lpnam1411/Scara_Robot/Scara_video_demo/3. Ảnh thực tế/received_490819612952527.jpeg

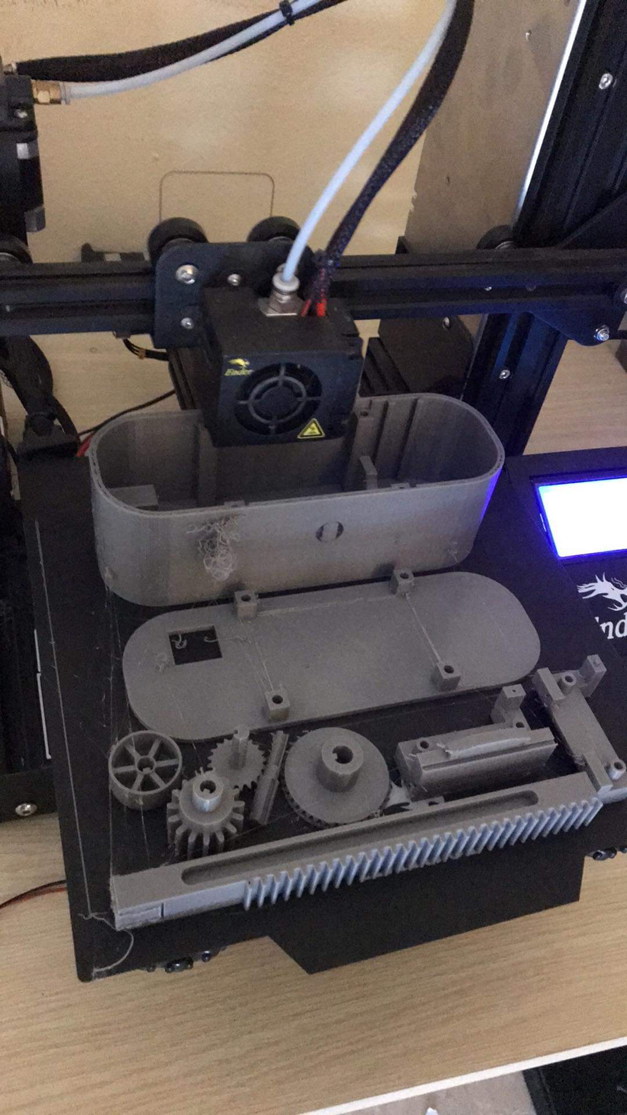
Scara_video_demo/3. Ảnh thực tế/received_490819612952527.jpeg
