lpnam1411/Scara_Robot/Scara_video_demo/2. Ảnh/IMG_20221110_121234.jpg

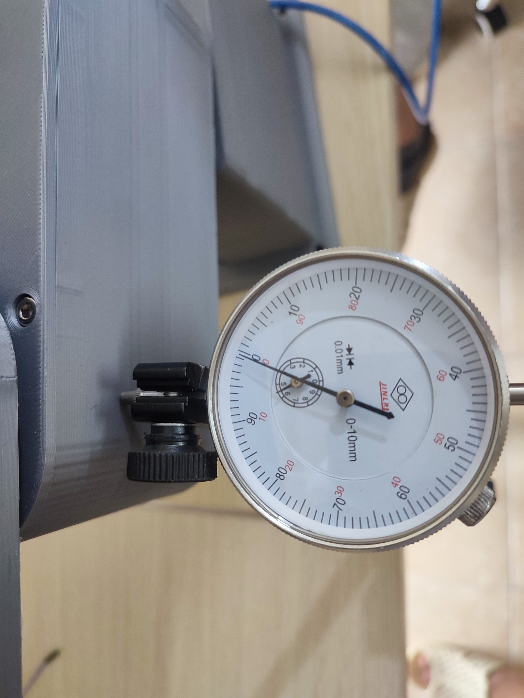
Scara_video_demo/2. Ảnh/IMG_20221110_121234.jpg
