lpnam1411/Scara_Robot/README.md

# Scara_Robot
 Bai tap lon Robot

Facebook: https://www.facebook.com/phannam.lee

Video demo: https://www.youtube.com/watch?v=TgQP_xQG-5g
