lpnam1411/Scara_Robot/Slide/Slide giữa kỳ - Robot Scara.pdf

# Thiết kế, chế tạo và khảo sát robot Scara

Thành viên:

Hoàng Văn Kiên

Đỗ Đức Mạnh

Lê Phấn Nam

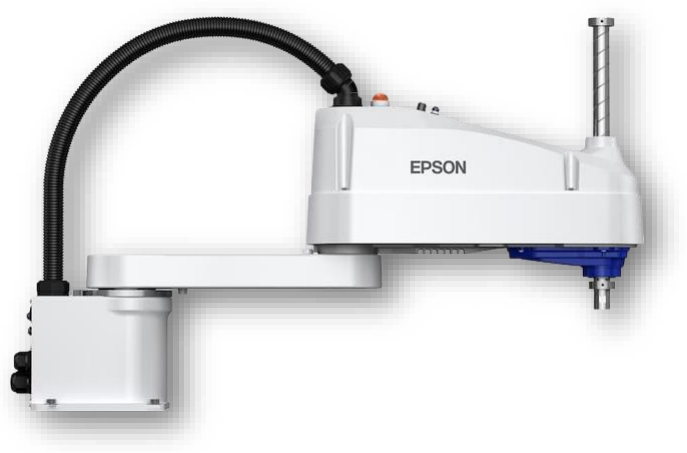
[picture p52: figure]

Giảng viên hướng dẫn:

TS. Dương Xuân Biên

## Nội dung

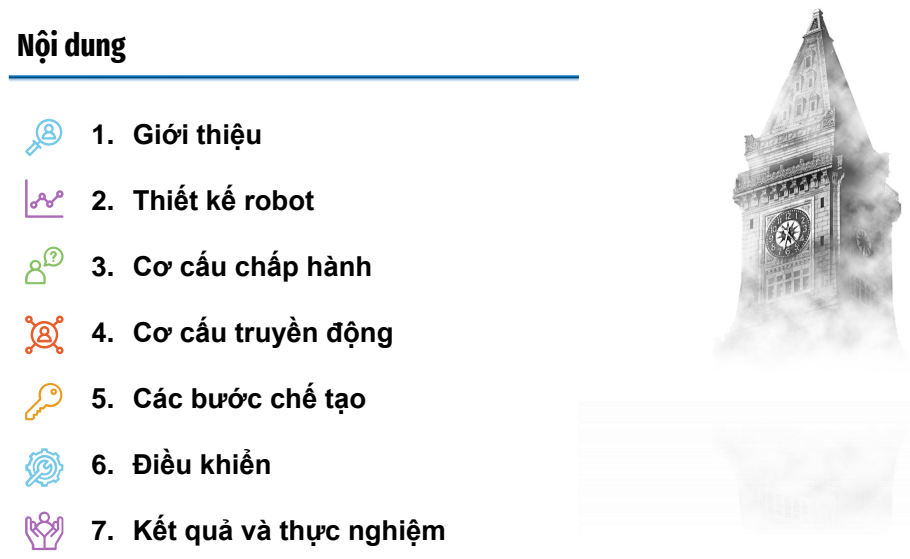
[picture p53: page 2]
1. Giới thiệu; 6. Điều khiển

2. Thiết kế robot

3. Cơ cấu chấp hành

4. Cơ cấu truyền động

5. Các bước chế tạo

7. Kết quả và thực nghiệm

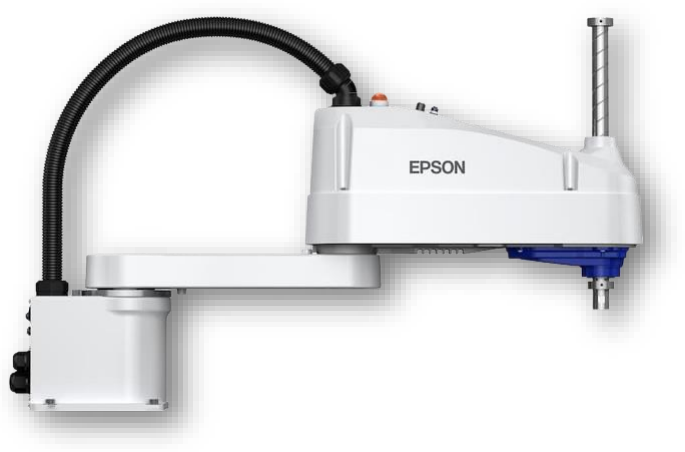
[picture p54: figure]

Robot Scara công nghiệp

## 1. Giới thiệu

- Robot Scara được đề xuất đầu tiên vào

năm 1979 tại Nhật Bản

- Ưu điểm:
- Tốc độ
- Chính xác tuyệt đối
- Độ lặp lại
- Khả năng linh động
a. Scara

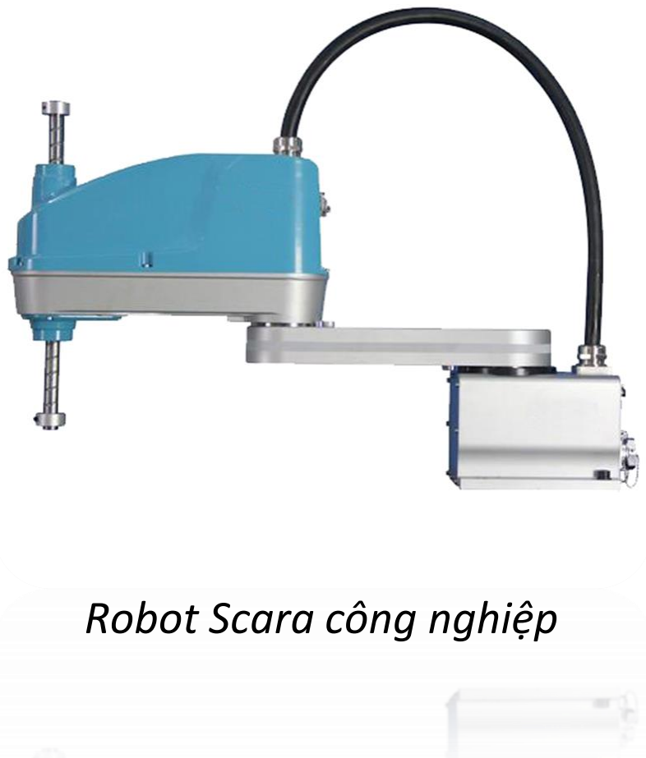
[picture p55: figure]
Robot Scara công nghiệp

Tay máy công nghiệp kích thước lớn,

độ chính xác tuyệt đối, giá thành cao.

Thiết kế robot Scara quy mô nhỏ, phù

hợp với sinh viên nghiên cứu và học tập.

## 1. Giới thiệu

b. Mục tiêu

## 1. Giới thiệu

c. Đề xuất thiết kế
Các tham số | Yêu cầu
Loại tay máy | Scara
Số bậc tự do | 3 bậc
Phạm vi hoạt động | Bán kính 20-30cm
Khối lượng | <=2kg
Vật liệu | Nhựa in PLA công nghệ in 3D
Chi phí | 3.000.000đ

## 2. Thiết kế robot

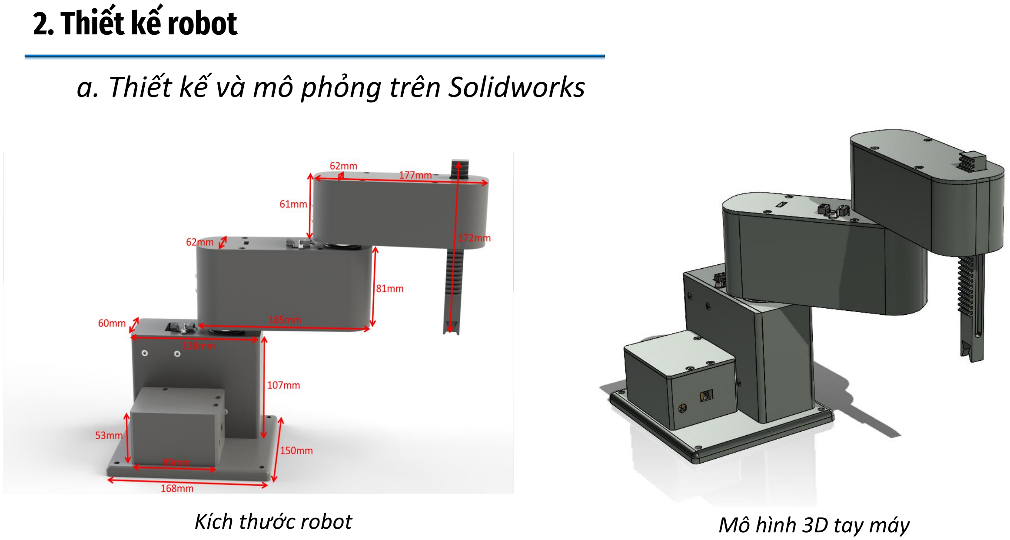
[picture p56: page 6]

a. Thiết kế và mô phỏng trên Solidworks
Kích thước robot | Mô hình 3D tay máy

## 2. Thiết kế robot

a. Thiết kế và mô phỏng trên Solidworks

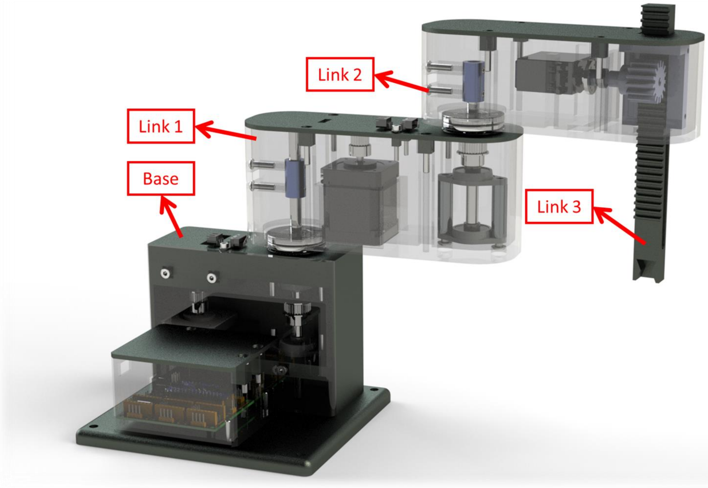
[picture p57: figure]

## 2. Thiết kế robot

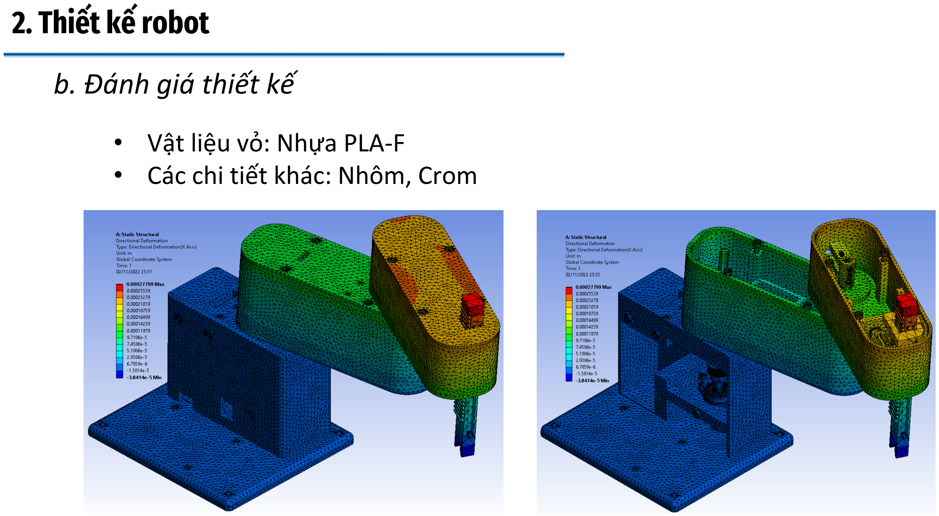
[picture p58: page 8]

b. Đánh giá thiết kế
- Vật liệu vỏ: Nhựa PLA-F
- Các chi tiết khác: Nhôm, Crom

## 3. Cơ cấu chấp hành

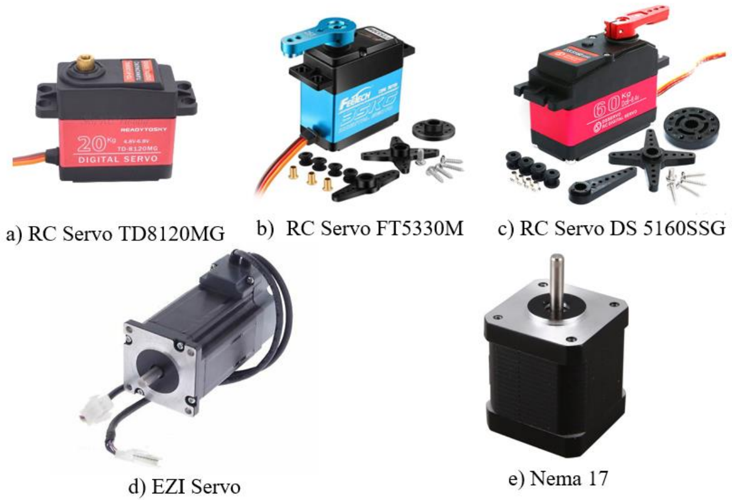
[picture p59: figure]

Các loại động cơ thường dùng trong tay máy robot

Tiêu chí

- Độ chính xác cao
- Điều khiển dễ dàng
- Tuổi thọ tốt
- Giá thành hợp lý
a. Lựa chọn động cơ

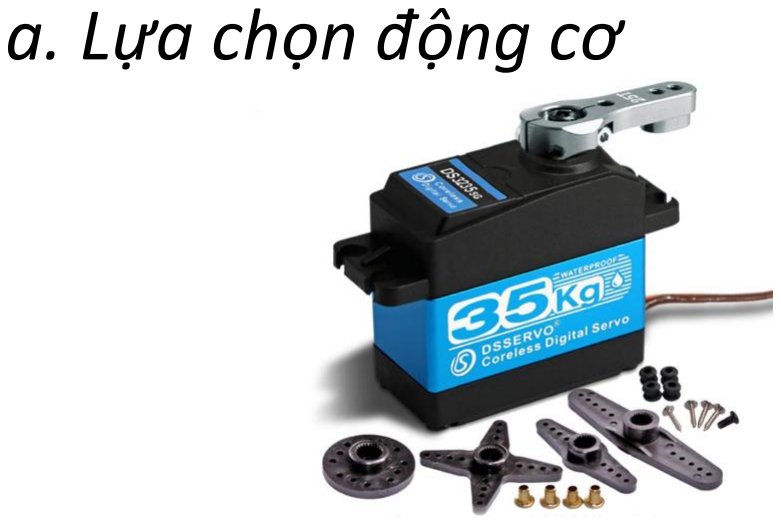
[picture p60: figure]
a. Lựa chọn động cơ
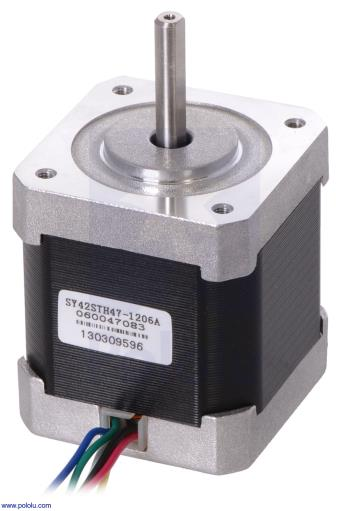
[picture p61: figure]

Servo motor | Step motor

## 3. Cơ cấu chấp hành

Đặc điểm | Servo | Step
Bước | 1 o | 1.8o – 1.8/16o
Vận tốc | Không | Có
Gia tốc | Không | Có
Driver | Tích hợp sẵn | Có
Encoder | Có | Không

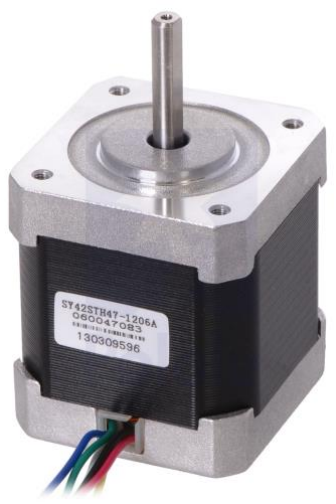
[picture p62: figure]

Nema 17HS8401s
Thông số | Nema 17HS8401s
Nguồn (V) | 12 - 24
Dòng (A) | 1.8
Momen xoắn (Ncm) | 2.6
Kích thước (mm) | 42 × 42 × 48
Khối lượng (g) | 368

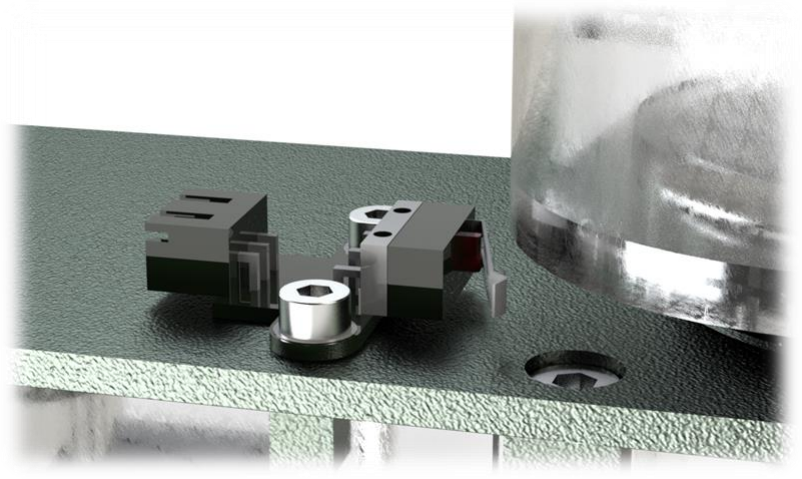
[picture p63: figure]
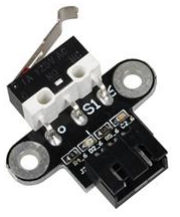
[picture p64: figure]

Công tắc hành trình

Trạng thái nút bấm | Giá trị trả về
Kích hoạt | 1
Chưa kích hoạt | 0

## 3. Cơ cấu chấp hành

b. Thông số động cơ

## 4. Cơ cấu truyền động

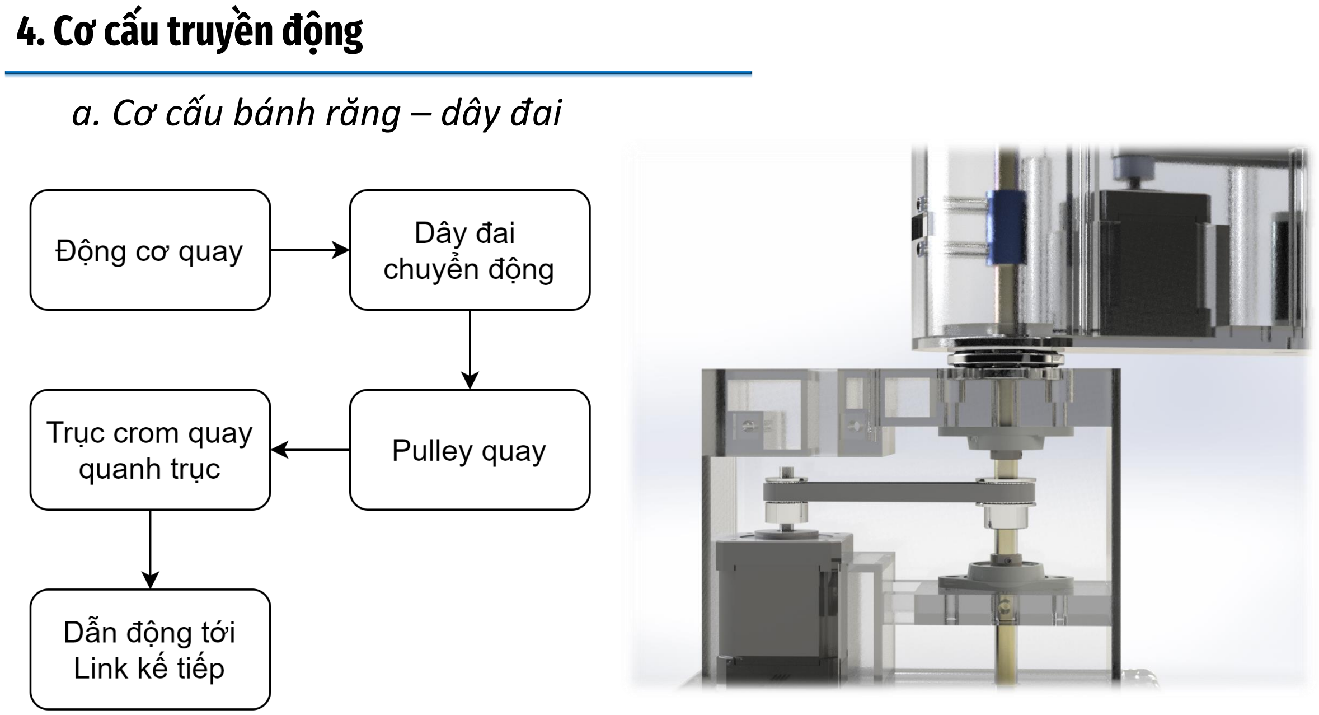
[picture p65: page 12]

a. Cơ cấu bánh răng – dây đai

## 4. Cơ cấu truyền động

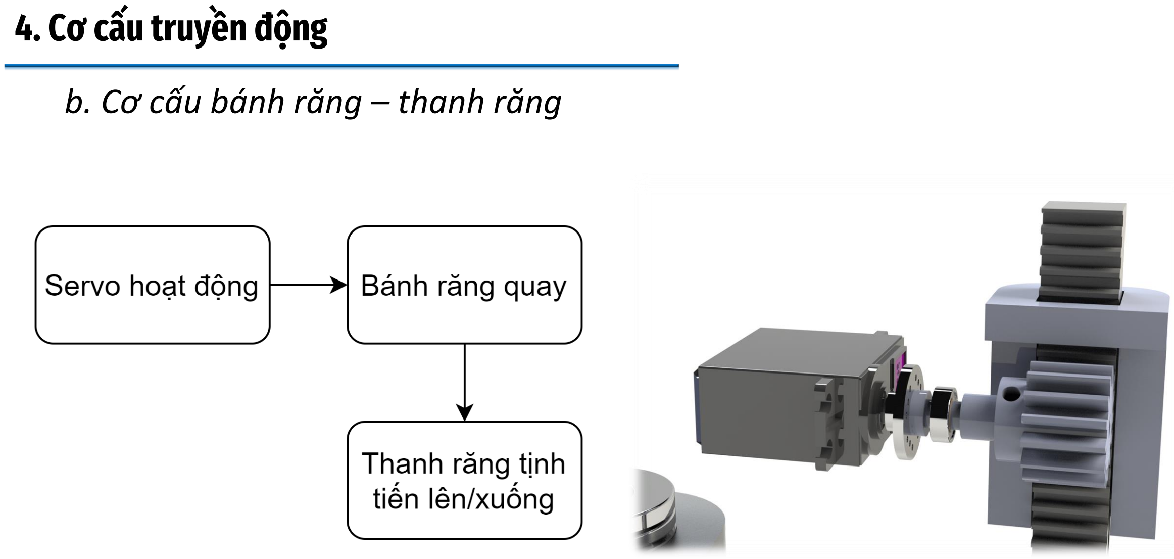
[picture p66: page 13]

b. Cơ cấu bánh răng – thanh răng

## 5. Các bước chế tạo

a. Video toàn cảnh

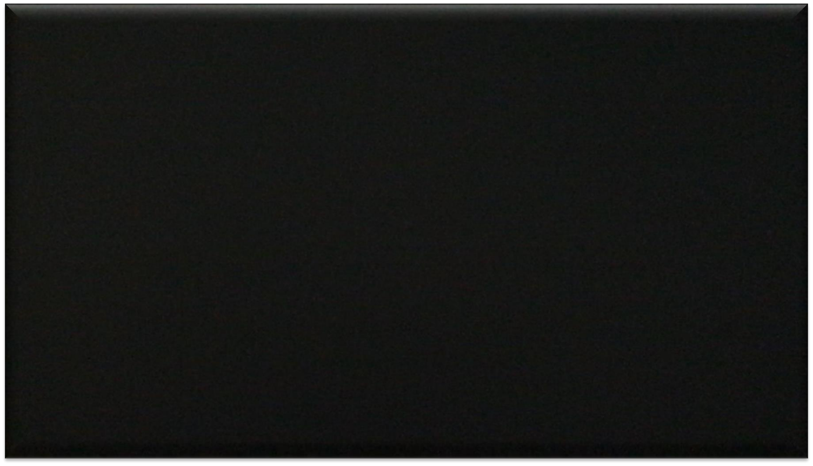
[picture p67: figure]

## 5. Các bước chế tạo

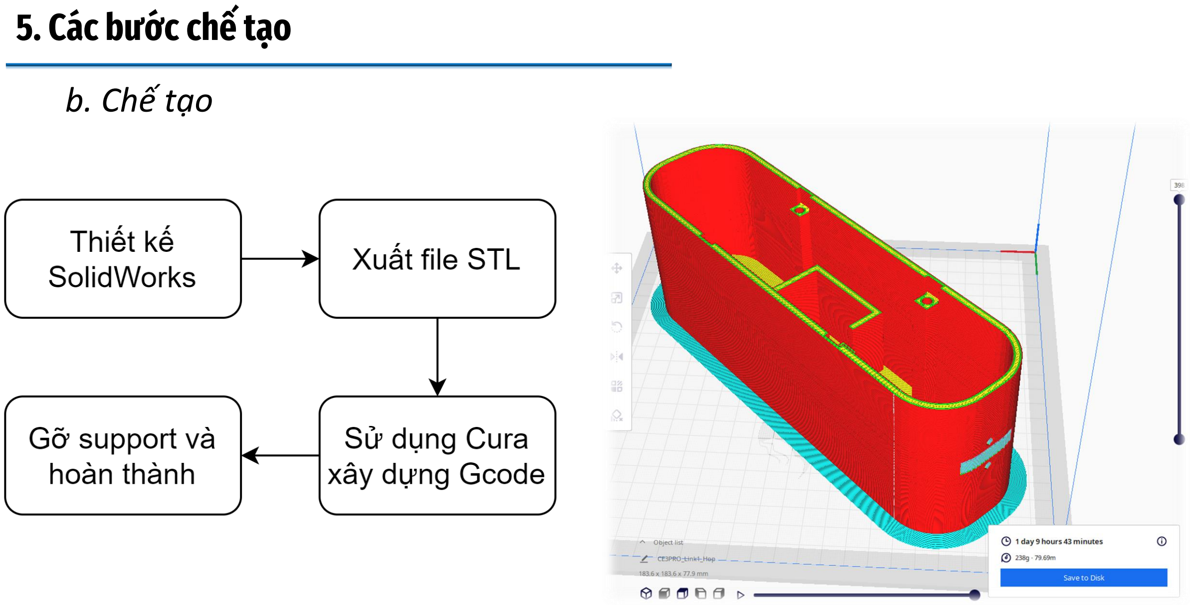
[picture p68: page 15]

b. Chế tạo

## 5. Các bước chế tạo

b. Chế tạo

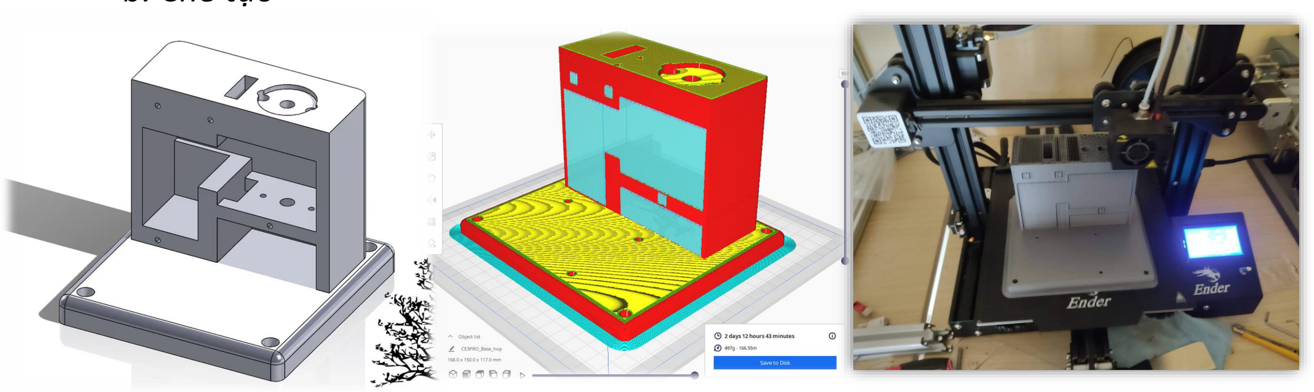
[picture p69: figure]

Mô phỏng SolidWorks | Xuất Gcode trên Cura | Bắt đầu in trên máy

## 5. Các bước chế tạo

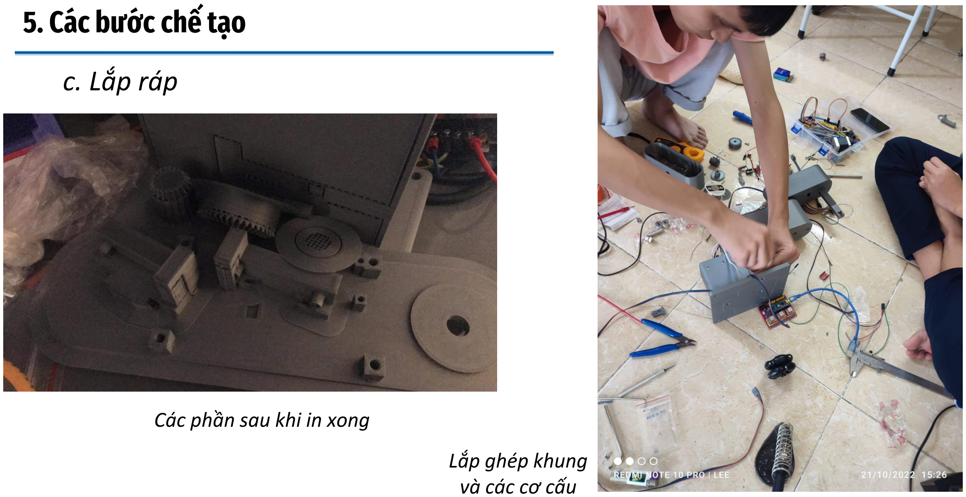
[picture p70: page 17]

c. Lắp ráp

Các phần sau khi in xong

Lắp ghép khung
và các cơ cấu

## 5. Các bước chế tạo

d. Sản phẩm

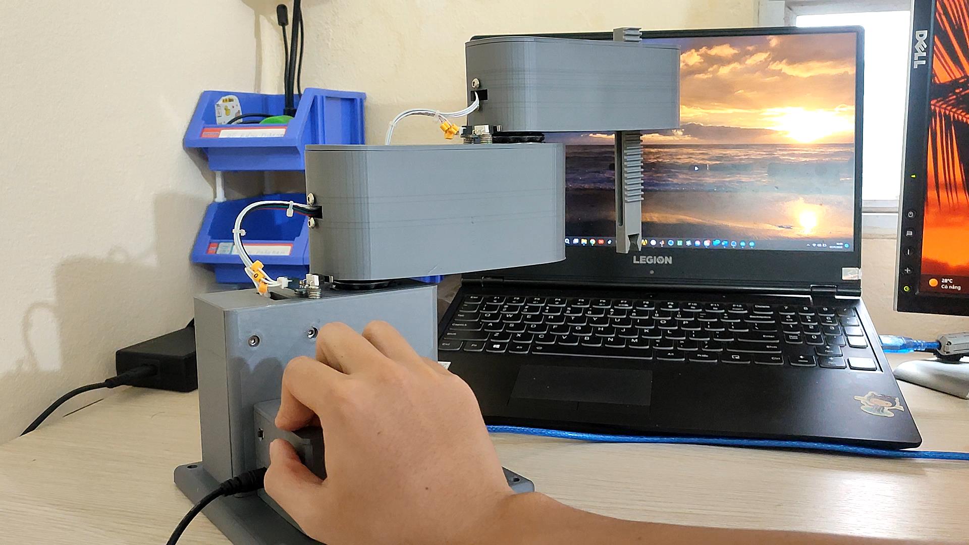
[picture p71: figure]

## 6. Điều khiển

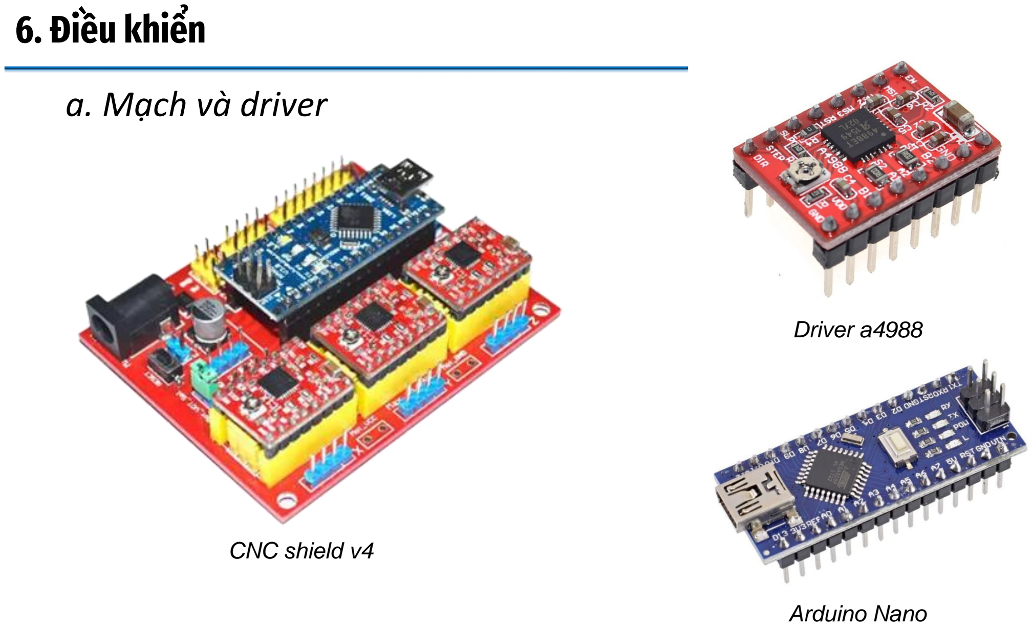
[picture p72: page 19]

a. Mạch và driver

CNC shield v4

Driver a4988

Arduino Nano

## 6. Điều khiển

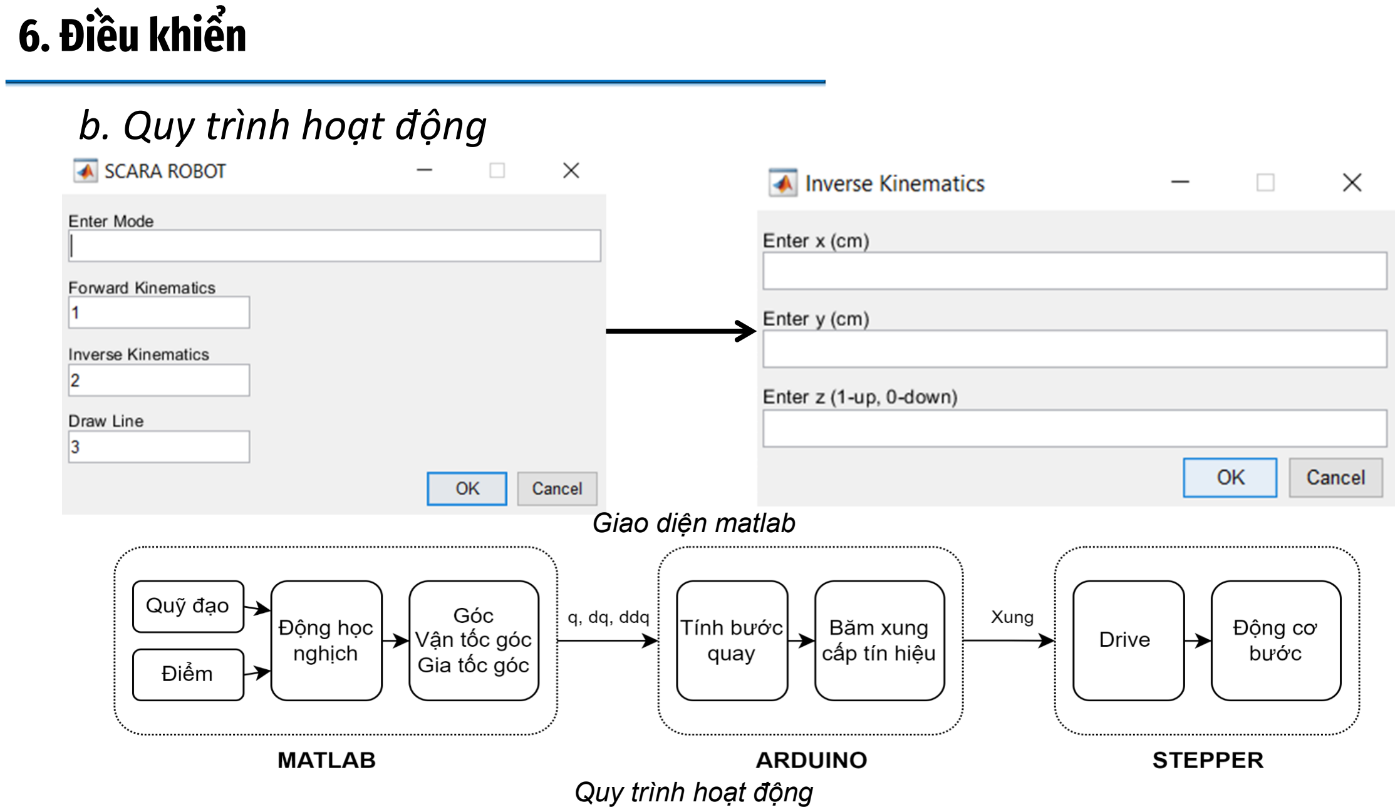
[picture p73: page 20]

b. Quy trình hoạt động

Quy trình hoạt động

Giao diện matlab

## 6. Điều khiển

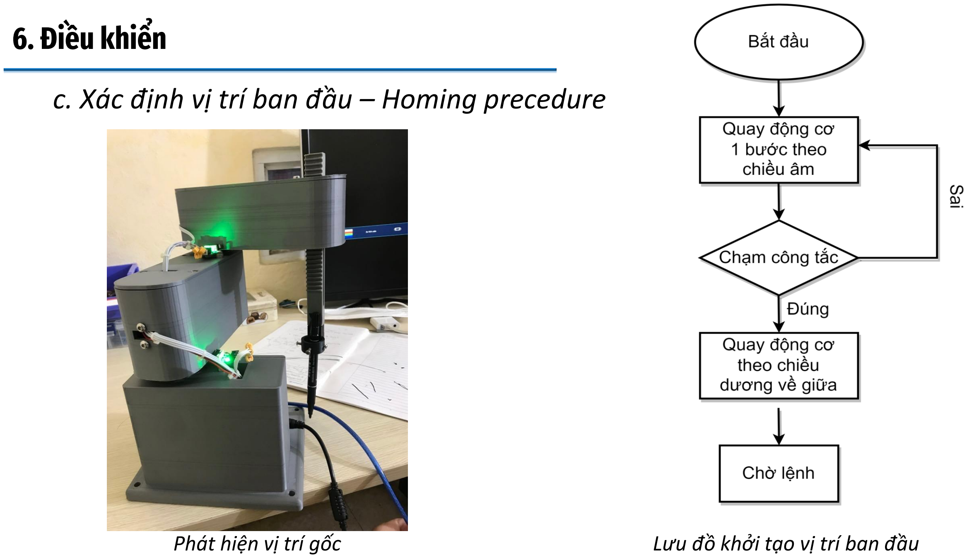
[picture p74: page 21]

c. Xác định vị trí ban đầu – Homing precedure
Phát hiện vị trí gốc | Lưu đồ khởi tạo vị trí ban đầu

## 6. Điều khiển

d. Phương pháp điều khiển
| Phương pháp hình học | Phương pháp toán học
Động học thuận | x L L 1 1 1 1 + + L 2 L 2 2 2 sin θ cos θ θ θ ( θ θ ( 1 1 + sin + cos 2 = 2 = ) y )
Động học nghịch | L x + L x cos θ − L y sin θ θ = arctan 1 2 2 2 2 2 2 2 1 L y + L y cos θ + L x sin θ 1 2 2 2 2 2 2 2 2 2 ( 2 2 ) x + y − L + L 2 2 1 2 θ = arccos 2 2 LL 12 | ~ J E k 1 θ k ( ) k θ k θ t ⁺ + = + Δ

Trong đó:
( ) ( ) ( ) ( )

1
θ | θ | θ | θ

−
+
= | é | ù ë | û T | T J | J | J | J k | θ | θ θ

θ

∂
∂
f E = | =J( ) ( )
n θ | θ Î | Î m E =f | ,E R , | R

## 7. Kết quả và thực nghiệm

a. Video demo, chuyển động theo chữ A

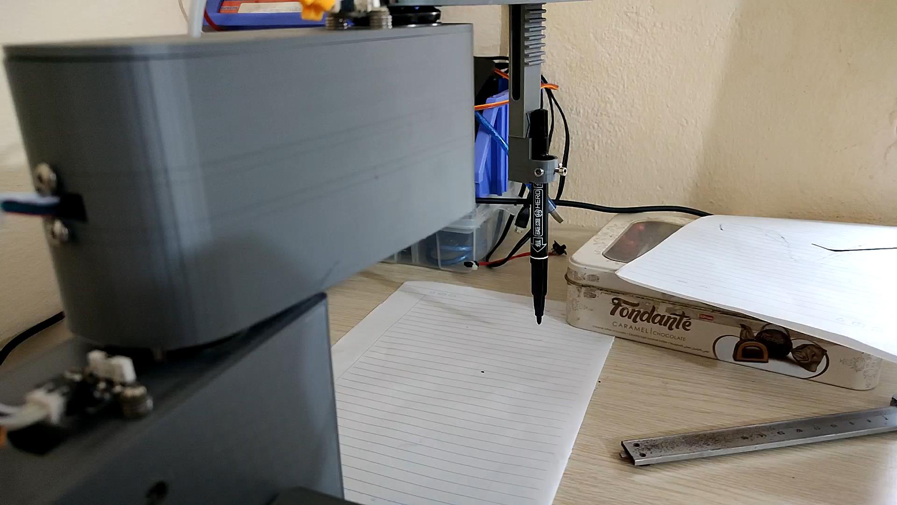
[picture p75: figure]

## 7. Kết quả và thực nghiệm

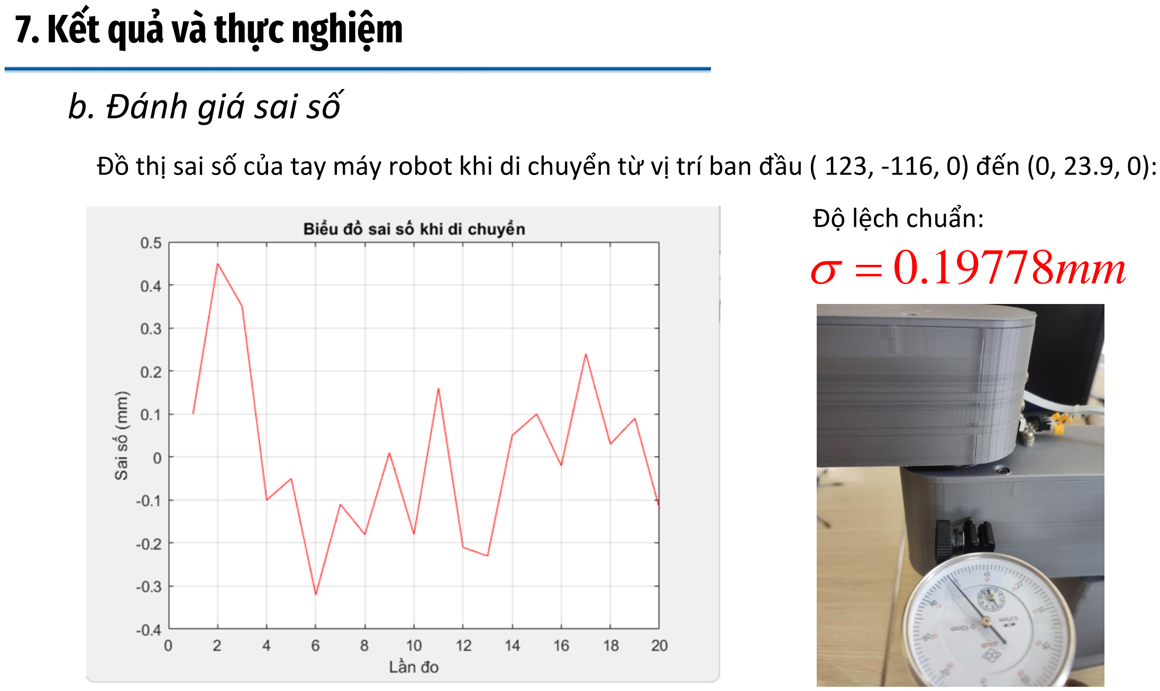
[picture p76: page 24]

b. Đánh giá sai số

Đồ thị sai số của tay máy robot khi di chuyển từ vị trí ban đầu ( 123, -116, 0) đến (0, 23.9, 0):

Độ lệch chuẩn:

## σ = 0.19778mm

## 7. Kết quả và thực nghiệm

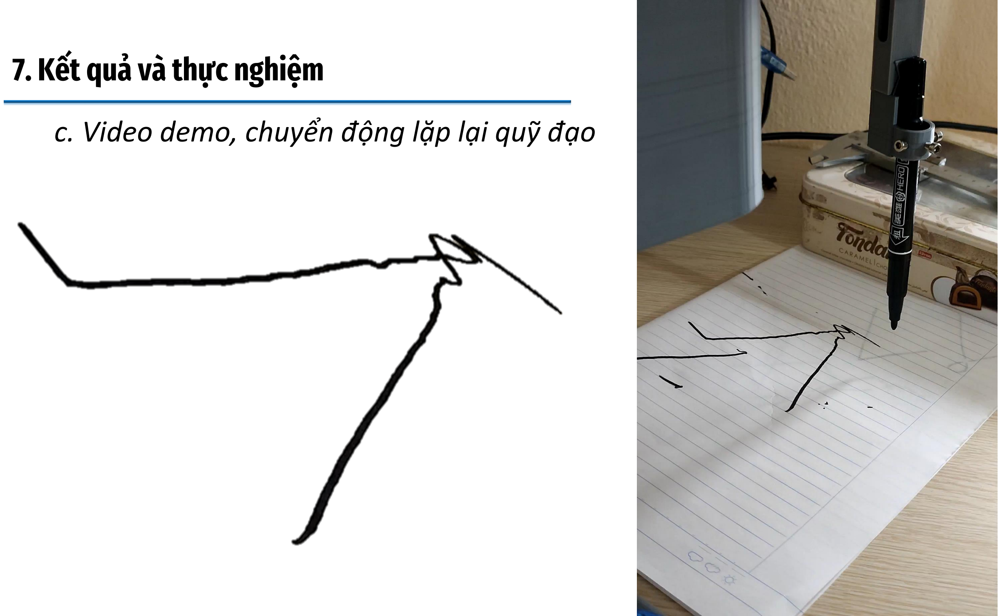
[picture p77: page 25]

c. Video demo, chuyển động lặp lại quỹ đạo

## 7. Kết quả và thực nghiệm

d. Video demo, chuyển động vẽ dấu tick “✓”

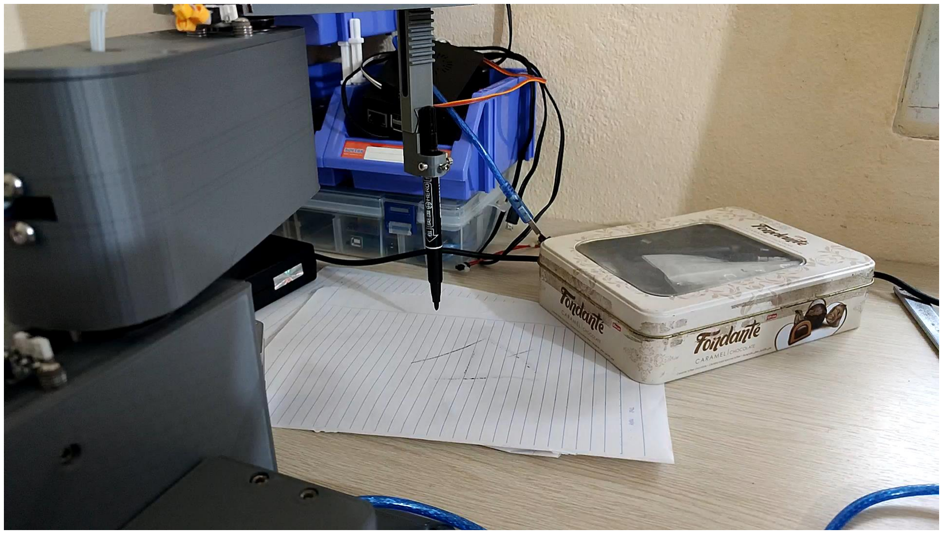
[picture p78: figure]

## 7. Kết quả và thực nghiệm

d. Video demo, chuyển động vẽ dấu tick “✓”

## 7. Kết quả và thực nghiệm

e. Bảng đánh giá thực tế
Tiêu chí | Thực tế
Phạm vi hoạt động | 24.1 cm
Khối lượng | 1.4 kg
Độ chính xác | ± 0.1977 mm
Tốc độ | 1.5 rpm
Giá thành | 4,000,000 vnđ

## Khó khăn và khắc phục

a. Khó khăn
- Khung máy in 3D gây ra sai số so với mô hình mô phỏng ví dụ

như mặt đế hơi cong, các góc bo không được tròn.
- Mạch điều khiển giá thành rẻ, xuất hiện nhiễu nhiều.
- Động cơ chưa đáp ứng được tải khi robot hoạt động .
- Giao tiếp matlab to Arduino chưa ổn định.
- Giao diện điều khiển chưa hoàn chỉnh.
- Phương pháp điều khiển hình học còn tồn tại điểm kì dị gây ra

tính toán góc sai.

## Khó khăn và khắc phục

b. Định hướng tương lai
- Tích hợp thêm cảm biến khoảng cách, giúp phần cân bàn cho

điểm E được tự động hoá và chính xác hơn.

- Sử dụng thêm camera, xử lý ảnh phát hiện vật và gắp vật.
- Tích hợp xử lý ảnh, nhận diện ảnh có sẵn và vẽ theo mẫu.
- Cải thiện về tốc độ cho robot, nâng cao tính ổn định khi

chuyển động với vận tốc cao đồng thời giảm sai số, khi hoạt

động của robot.

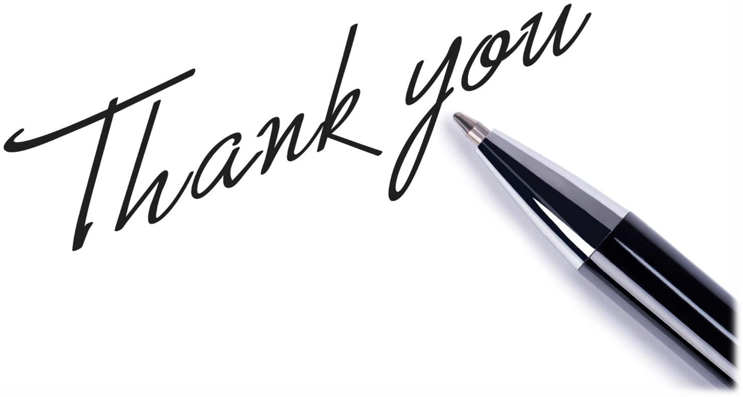
[picture p79: page 31]
