lpnam1411/Scara_Robot/Scara_Code/1. Động học/1. maple/Scara_Kinematic.docx

SCARA

A. Mô hình Robot SCARA
I. Phân tích mô hình Robot

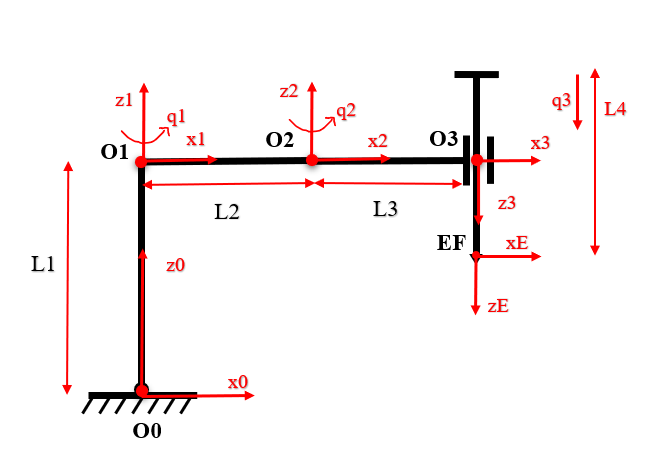
[picture p80: figure]

Hình 1: Mô hình Robot SCARA

II. Mô hình hóa toán học
1. Đặt hệ trục tọa độ cố định và địa phương
2. Lập bảng DH:

Bảng 1.

Dịch chuyển | Khâu | Q | D | A | Anpha
0-1 | | 0 | L1 | 0 | 0
1-2 | | Q1 | 0 | L2 | 0
2-3 | | Q2 | 0 | L3 | Pi
3-E | | 0 | Q3 | 0 | 0
