lpnam1411/Scara_Robot/Scara_Code/1. Động học/3. Phương trình hình học/Giải hình học.docx

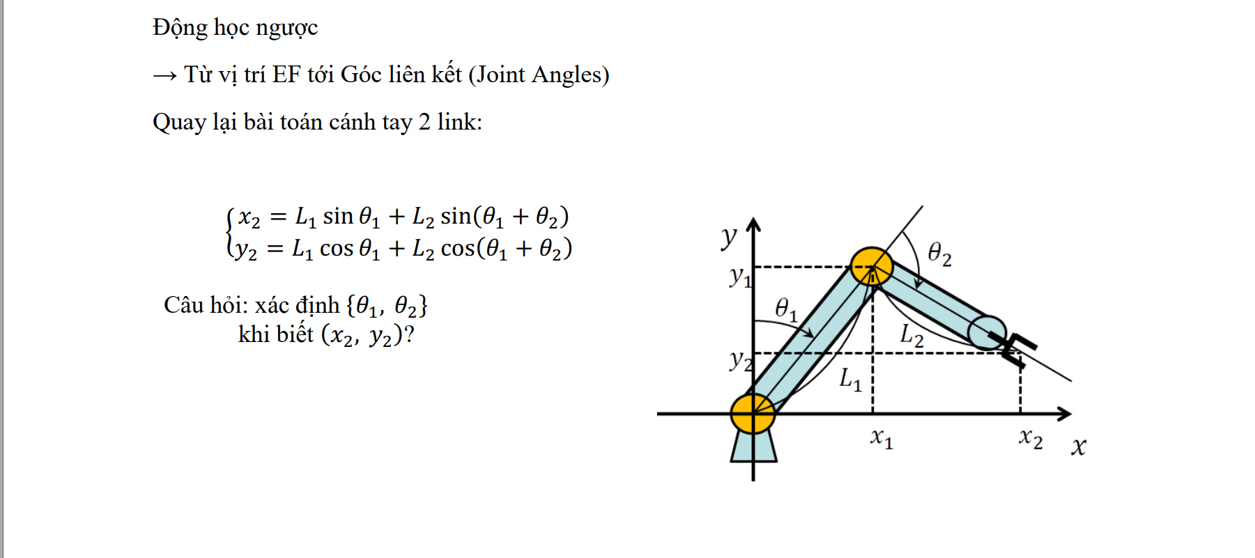
[picture p81: figure]
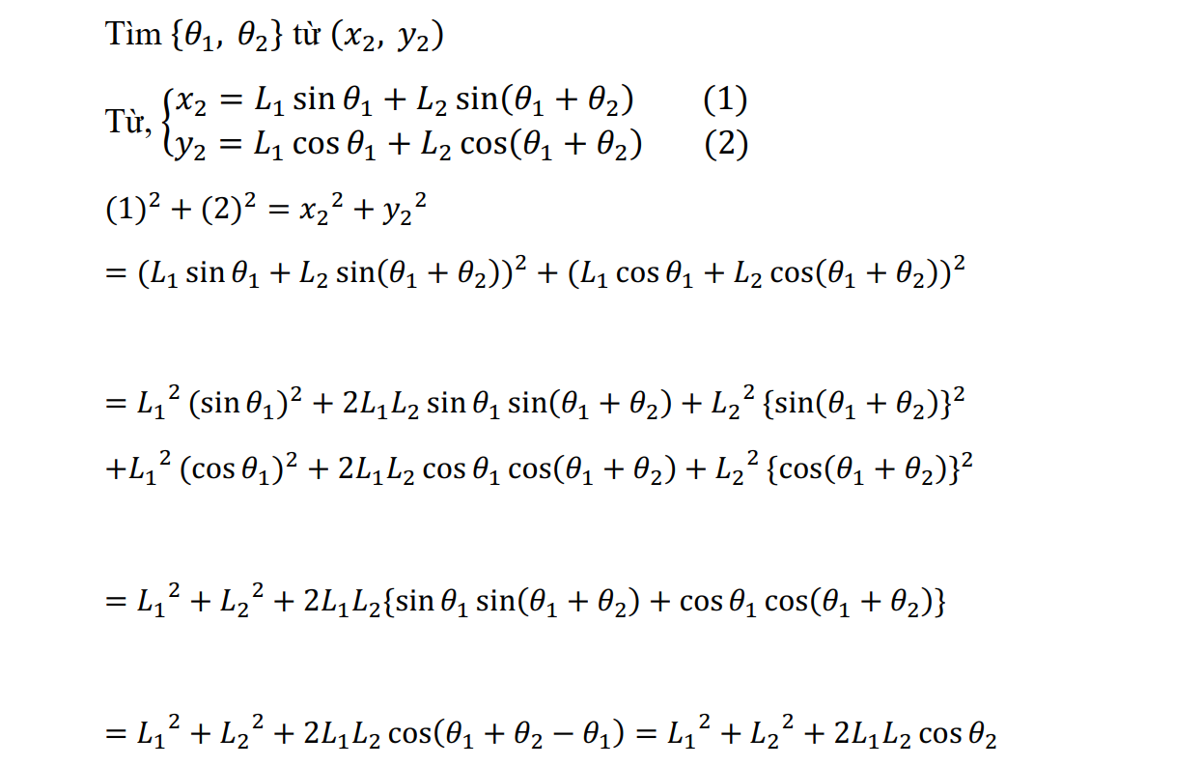
[picture p82: figure]
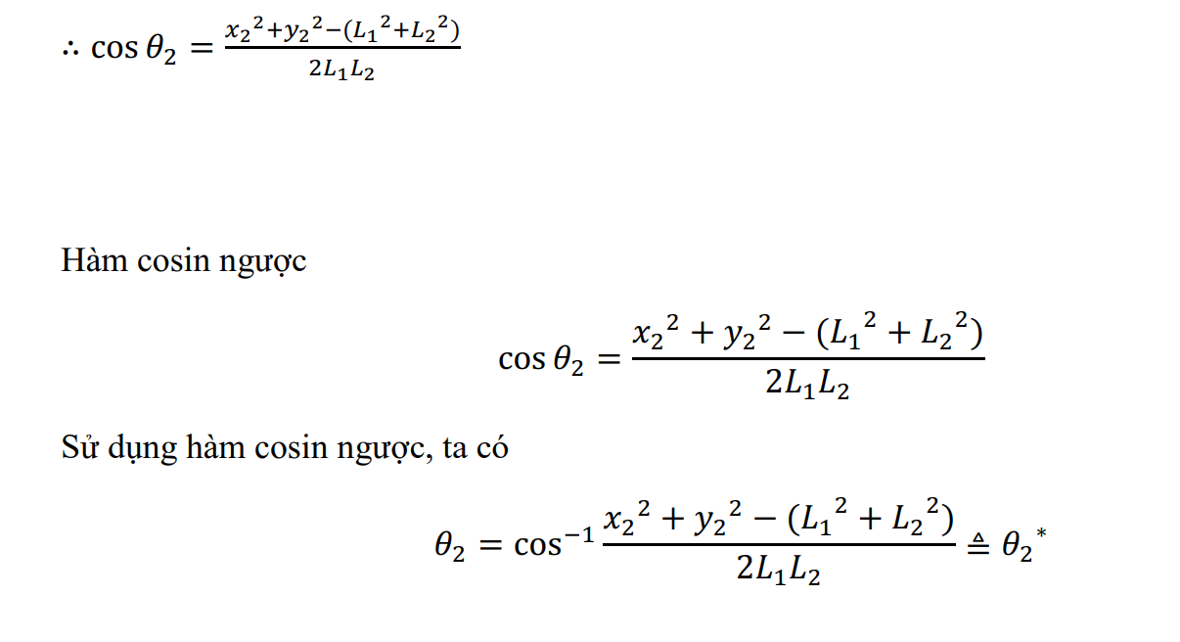
[picture p83: figure]
