lpnam1411/Scara_Robot/Scara_video_demo/3. Ảnh thực tế/base_slw.webp

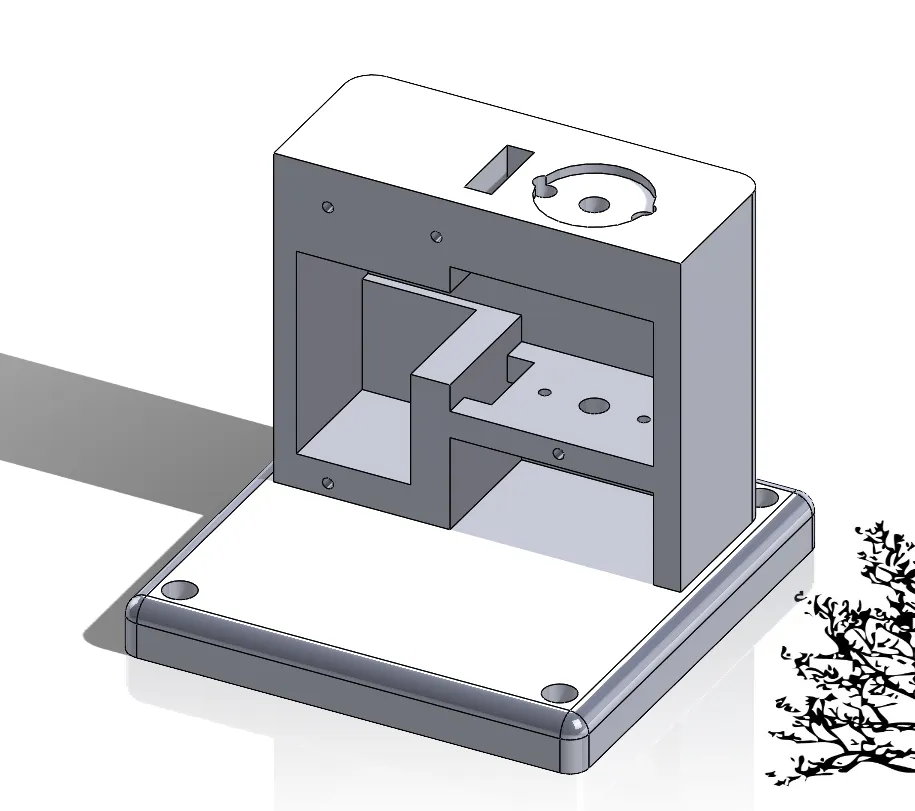
Scara_video_demo/3. Ảnh thực tế/base_slw.webp
