lpnam1411/Scara_Robot/Scara_video_demo/3. Ảnh thực tế/linh kiện.jpeg

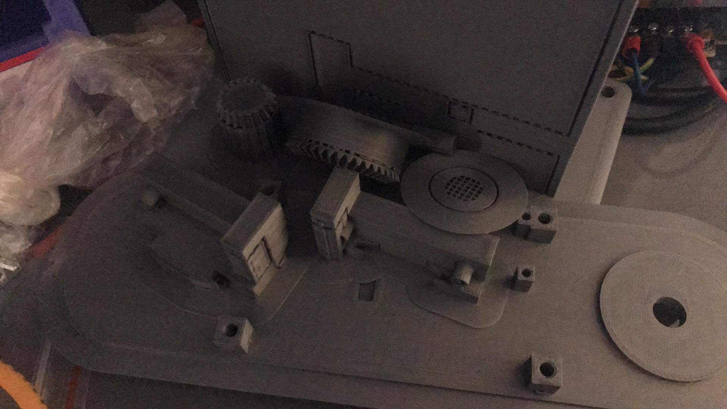
Scara_video_demo/3. Ảnh thực tế/linh kiện.jpeg
