lpnam1411/Scara_Robot/Scara_video_demo/3. Ảnh thực tế/lắp.jpeg

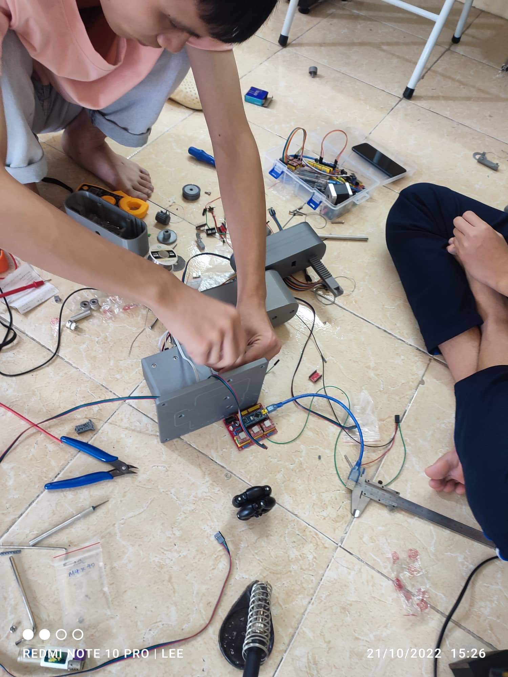
Scara_video_demo/3. Ảnh thực tế/lắp.jpeg
