lpnam1411/Scara_Robot/Scara_video_demo/3. Ảnh thực tế/received_675763930218119.webp

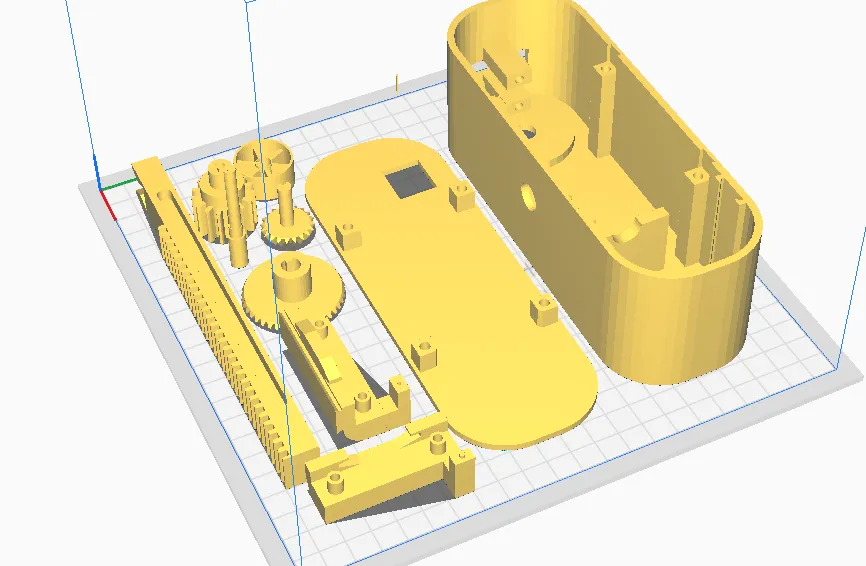
Scara_video_demo/3. Ảnh thực tế/received_675763930218119.webp
