lpnam1411/Scara_Robot/Scara_video_demo/3. Ảnh thực tế/received_858242992252694.jpeg

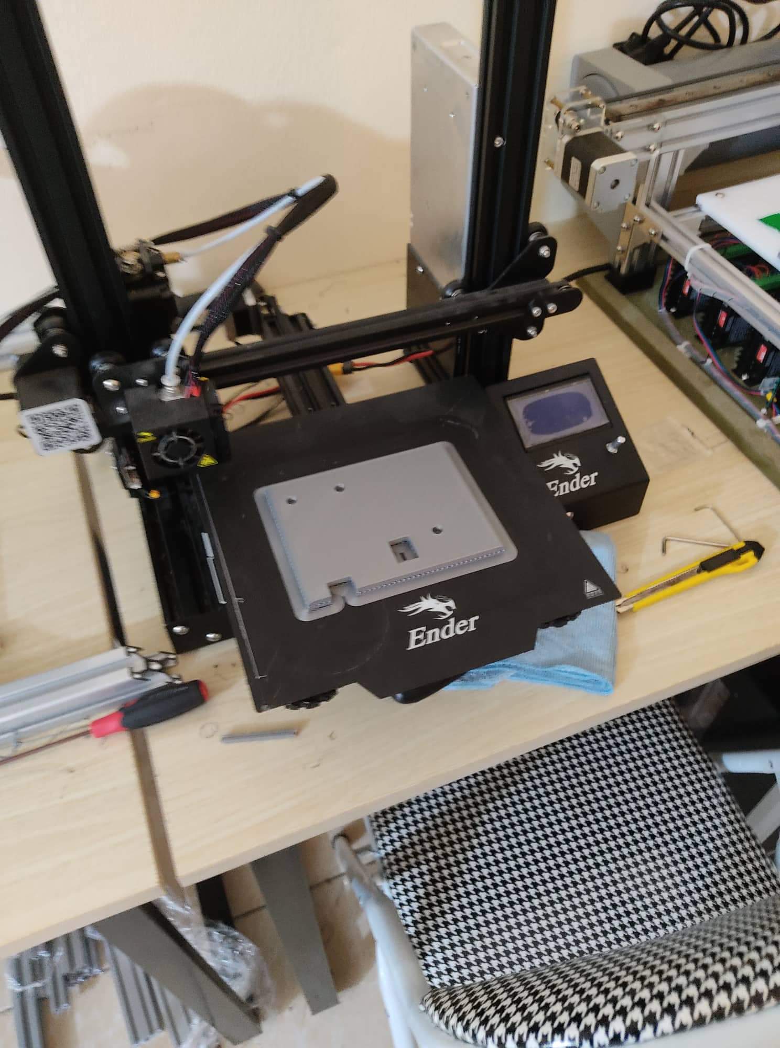
Scara_video_demo/3. Ảnh thực tế/received_858242992252694.jpeg
