lpnam1411/Scara_Robot/Scara_video_demo/3. Ảnh thực tế/received_1276213099846674.jpeg

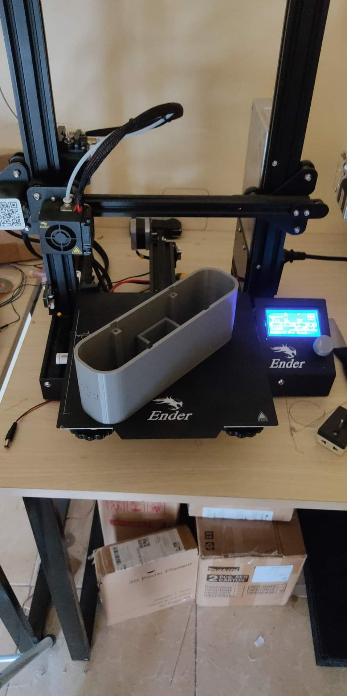
Scara_video_demo/3. Ảnh thực tế/received_1276213099846674.jpeg
