lpnam1411/Scara_Robot/Scara_3D_design/Linh kiện/servo-mg-996r.SLDASM

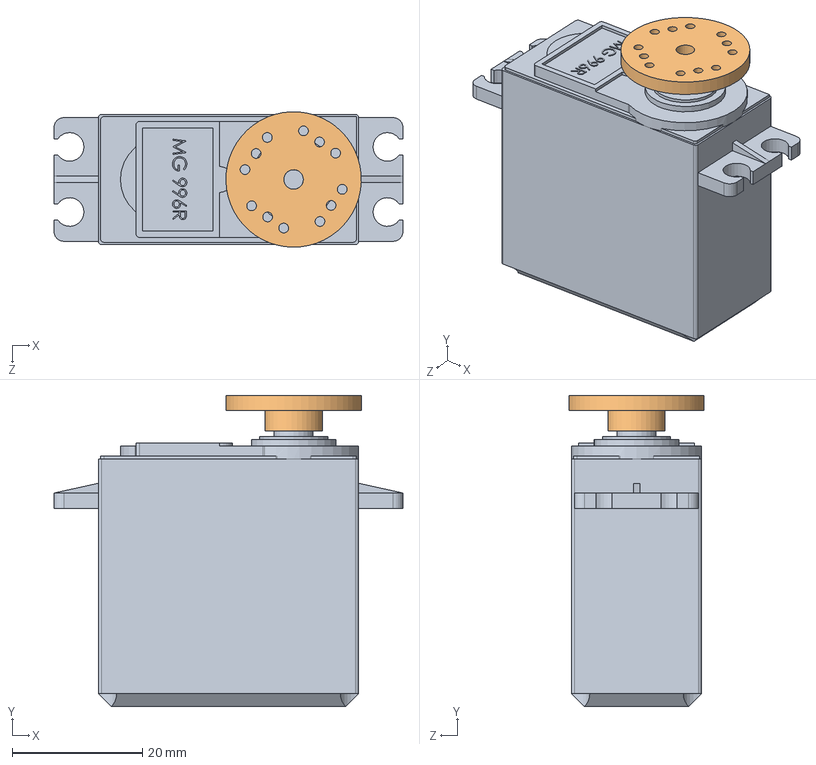
[picture p91: CAD file, 2023-01-28]
Scara_3D_design/Linh kiện/servo-mg-996r.SLDASM
53.6 x 47.8 x 20.8 mm
##Servo_MG_996R
Circle Rudder
