lpnam1411/Scara_Robot/Scara_3D_design/Trục/KFL08.SLDASM

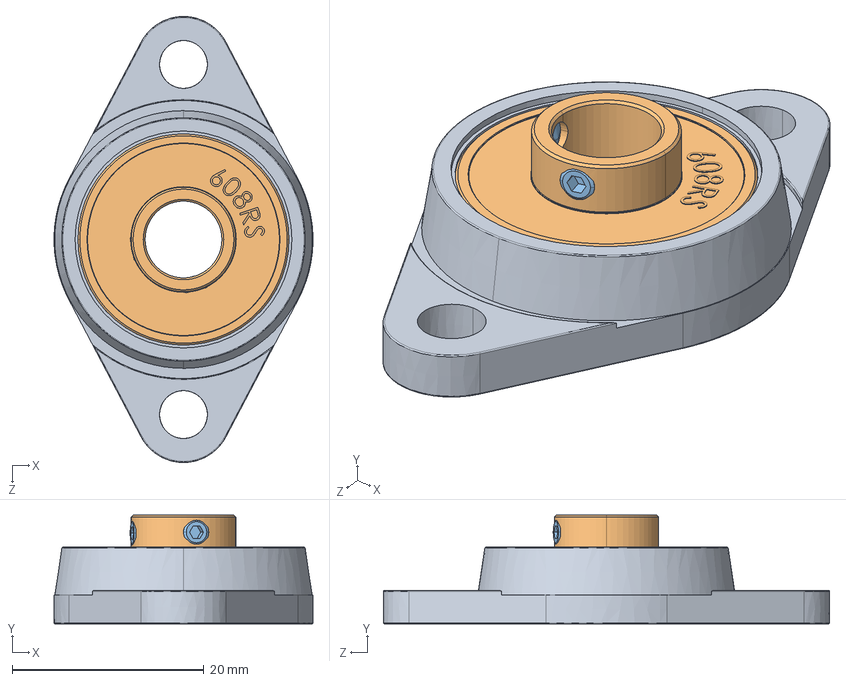
[picture p92: CAD file, 2023-01-28]
Scara_3D_design/Trục/KFL08.SLDASM
27.0 x 11.4 x 46.5 mm
KFL08.IGS
608RS.IGS
MOSCAM2,5.IGS x 2
