lpnam1411/Scara_Robot/Scara_3D_design/Rack and Pinion Gear/đỡ.SLDASM

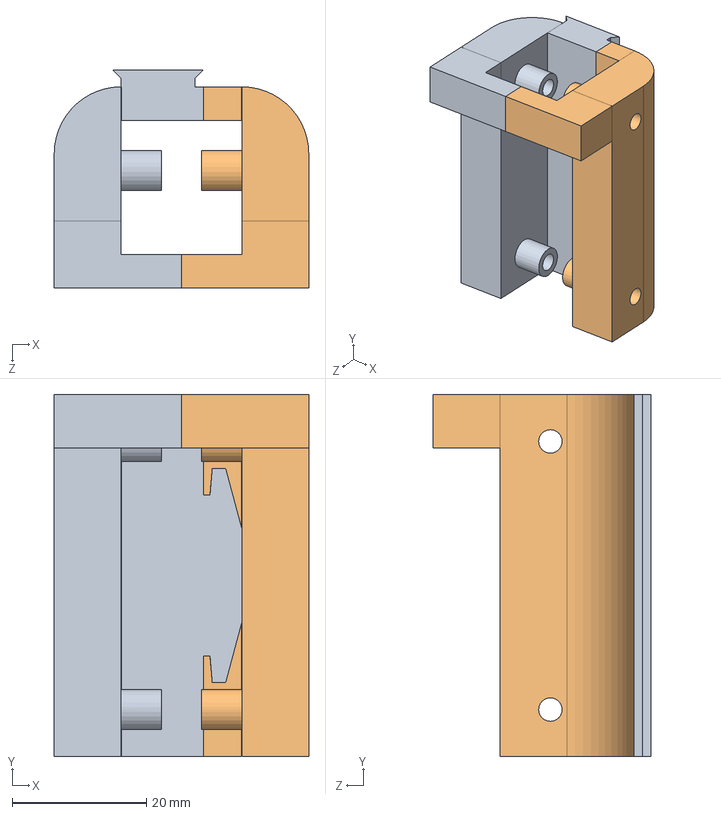
[picture p93: CAD file, 2023-01-28]
Scara_3D_design/Rack and Pinion Gear/đỡ.SLDASM
38.0 x 54.0 x 32.5 mm
Penyanga Rack - Copy
Penyanga Rack
