lpnam1411/Scara_Robot/Scara_3D_design/Linh kiện/Arduino Nano/Arduino nano.SLDASM

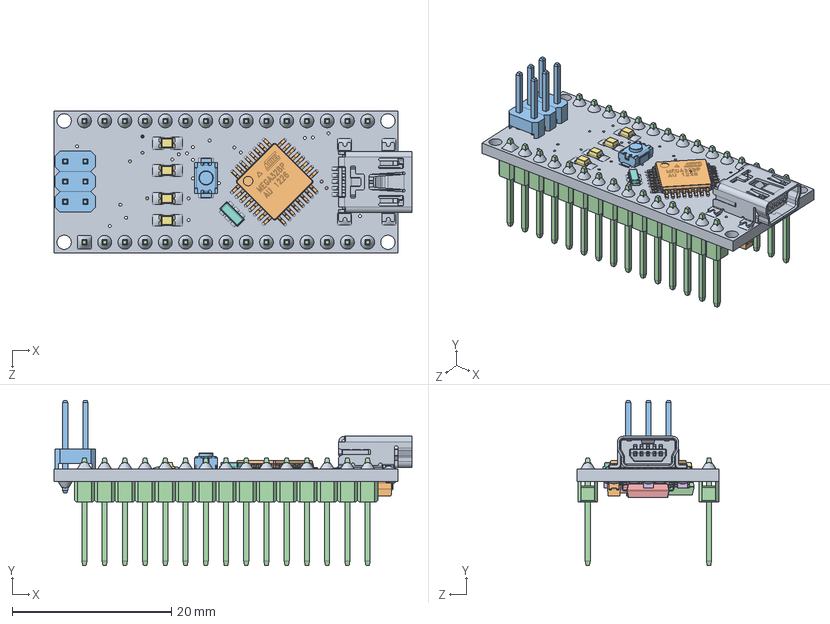
[picture p94: CAD file, 2023-01-28]
Scara_3D_design/Linh kiện/Arduino Nano/Arduino nano.SLDASM
45.0 x 20.7 x 17.8 mm
nano board
atmega328
PLD-2.step x 3
1x15 Male Pin Header x 2
FTDI FT232RL
User Library-C0805-2.step x 5
0805 Chip SMD LED (2x1.2mm).step x 4
SMD Crystal 16MHz
Mini B USB
Tantalum Capacitor 475C A3216 x 2
Pushbutton3x4x2
C5 FD10 Reg
Diode MBR0520
102 RESISTOR PACK
189 RESISTOR PACK
