lpnam1411/Scara_Robot/Scara_3D_design/Gripper/Gripper base bút.SLDPRT

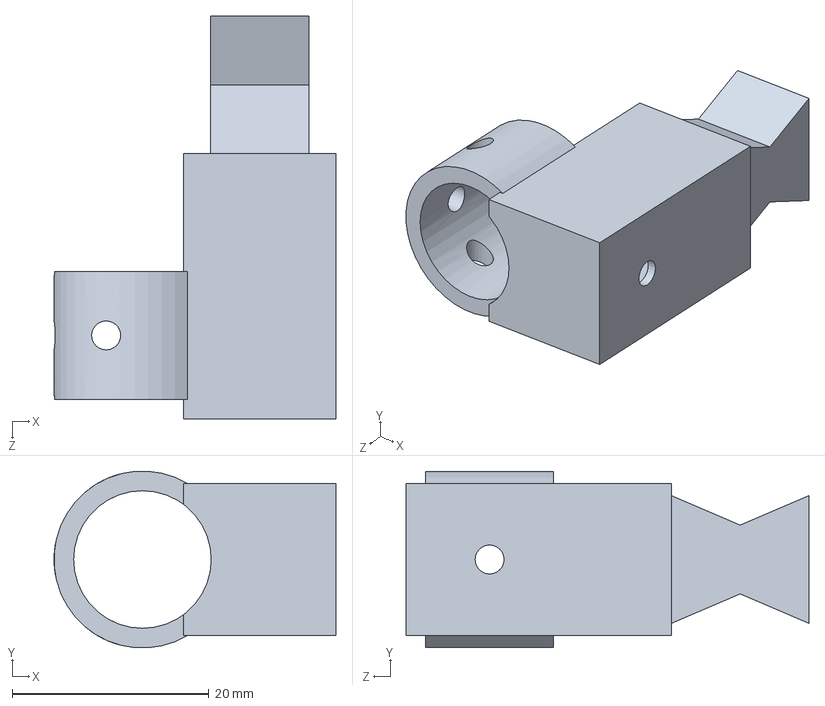
[picture p95: CAD file, 2023-01-28]
Scara_3D_design/Gripper/Gripper base bút.SLDPRT
28.7 x 18.0 x 41.0 mm
