lpnam1411/Scara_Robot/Scara_3D_design/Linh kiện/Arduino Nano/Mini B USB.SLDPRT

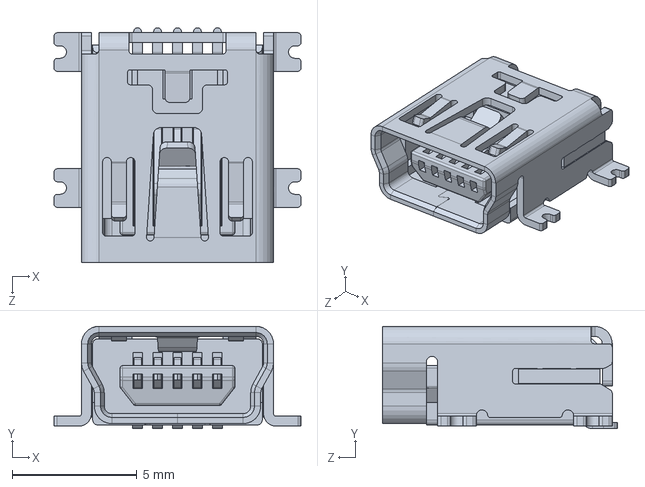
[picture p96: CAD file, 2023-01-28]
Scara_3D_design/Linh kiện/Arduino Nano/Mini B USB.SLDPRT
9.90 x 4.10 x 9.40 mm
