lpnam1411/Scara_Robot/Scara_3D_design/Linh kiện/servo-mg-996r-2.snapshot.1/Servo/##Servo_MG_996R.SLDPRT

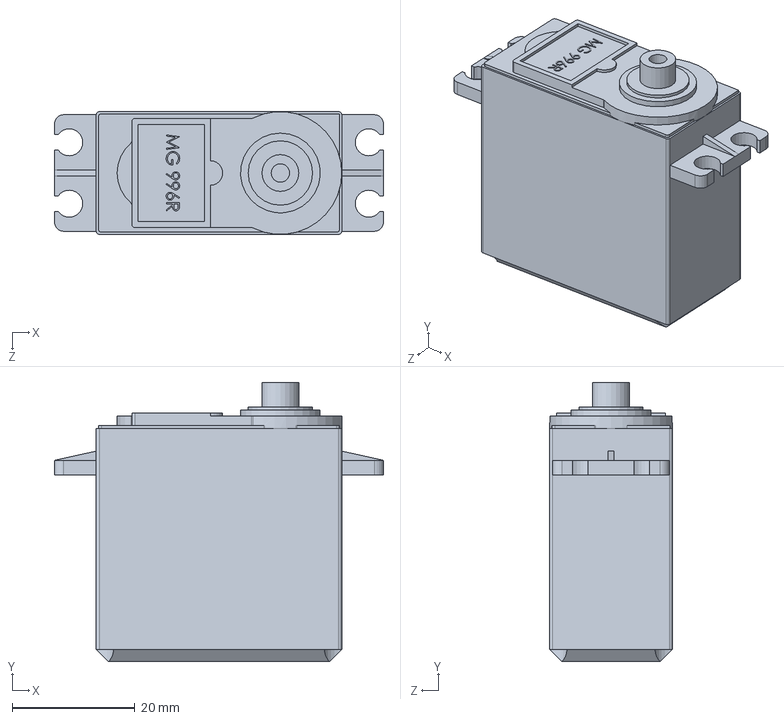
[picture p97: CAD file, 2023-01-28]
Scara_3D_design/Linh kiện/servo-mg-996r-2.snapshot.1/Servo/##Servo_MG_996R.SLDPRT
53.6 x 45.5 x 20.0 mm
