lpnam1411/Scara_Robot/Scara_3D_design/Link1_Hop.SLDPRT

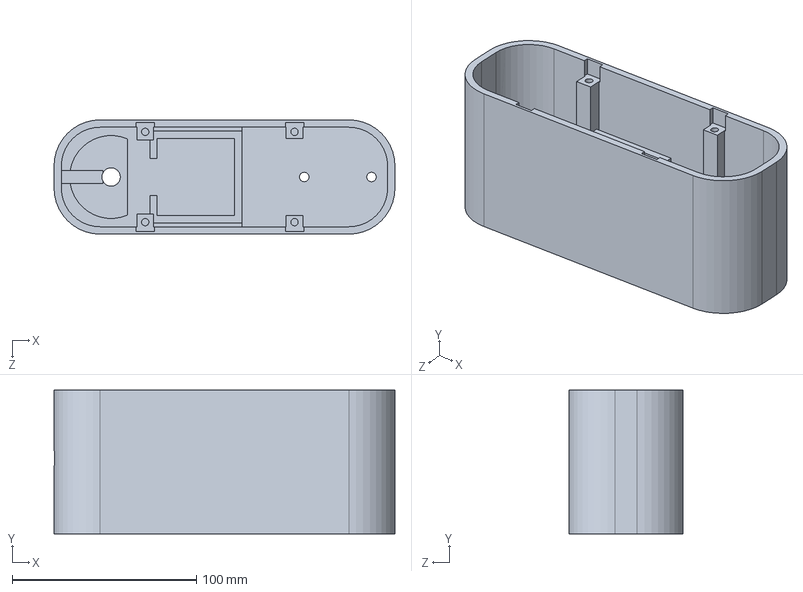
[picture p98: CAD file, 2023-01-28]
Scara_3D_design/Link1_Hop.SLDPRT
185.0 x 77.9 x 62.0 mm
