lpnam1411/Scara_Robot/Scara_3D_design/arduino_hop.SLDPRT

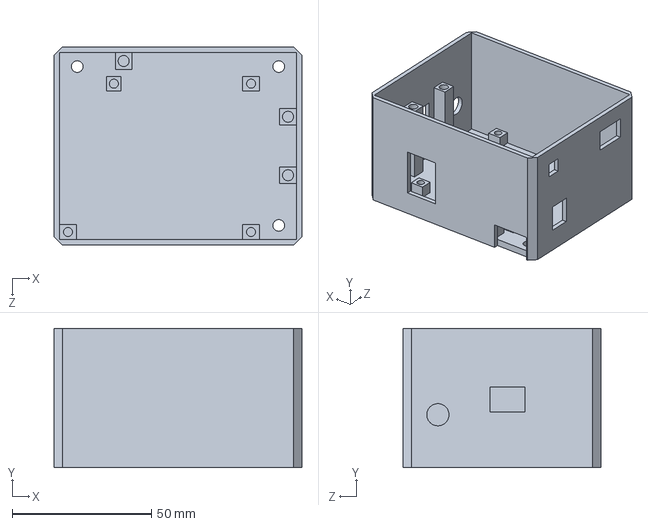
[picture p99: CAD file, 2023-01-28]
Scara_3D_design/arduino_hop.SLDPRT
89.0 x 50.0 x 71.0 mm
