lpnam1411/Scara_Robot/Scara_3D_design/Linh kiện/17HS8401_nema17_stepper-motor.sldprt

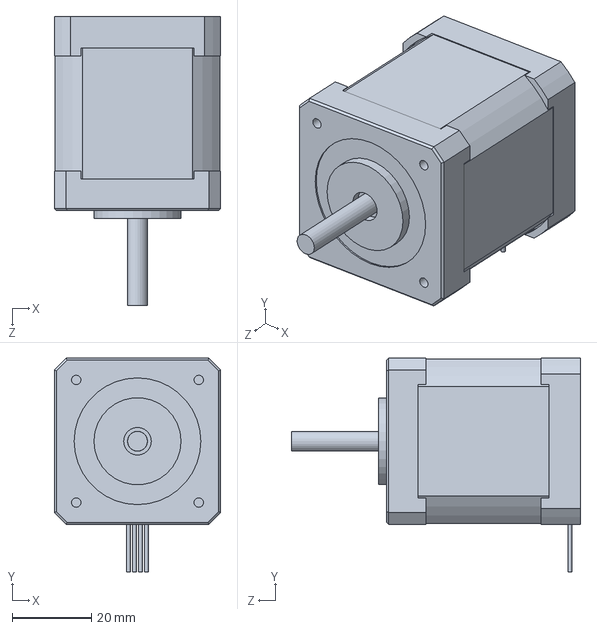
[picture p100: CAD file, 2023-01-28]
Scara_3D_design/Linh kiện/17HS8401_nema17_stepper-motor.sldprt
42.0 x 54.0 x 73.0 mm
