lpnam1411/Scara_Robot/Scara_3D_design/Linh kiện/Arduino Nano/nano board.SLDPRT

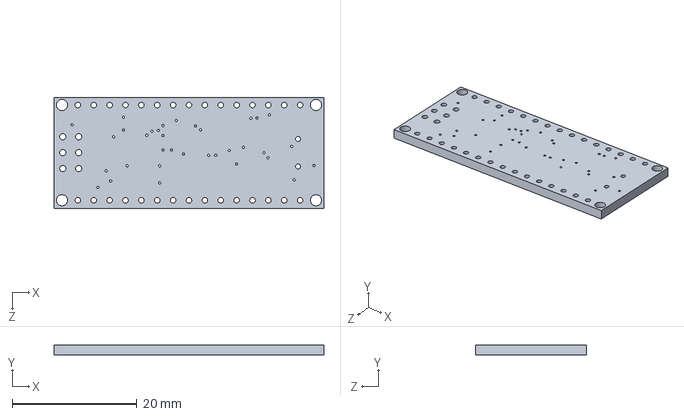
[picture p101: CAD file, 2023-01-28]
Scara_3D_design/Linh kiện/Arduino Nano/nano board.SLDPRT
43.2 x 1.60 x 17.8 mm
