lpnam1411/Scara_Robot/Scara_3D_design/Linh kiện/servo-mg-996r-2.snapshot.1/Servo/Circle Rudder.SLDPRT

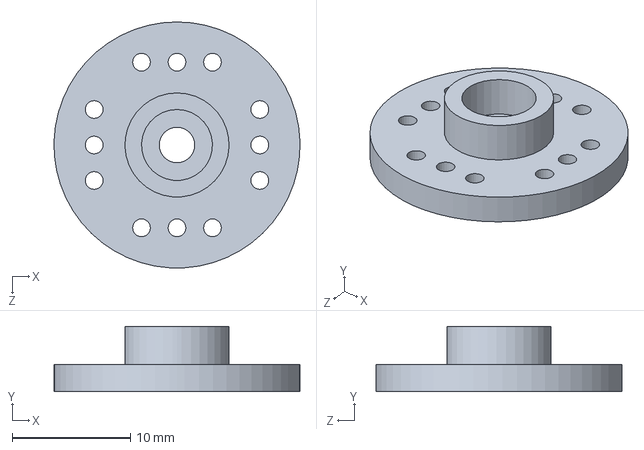
[picture p102: CAD file, 2023-01-28]
Scara_3D_design/Linh kiện/servo-mg-996r-2.snapshot.1/Servo/Circle Rudder.SLDPRT
20.8 x 5.50 x 20.8 mm
