lpnam1411/Scara_Robot/Scara_3D_design/Rack and Pinion Gear/Penyanga Rack.SLDPRT

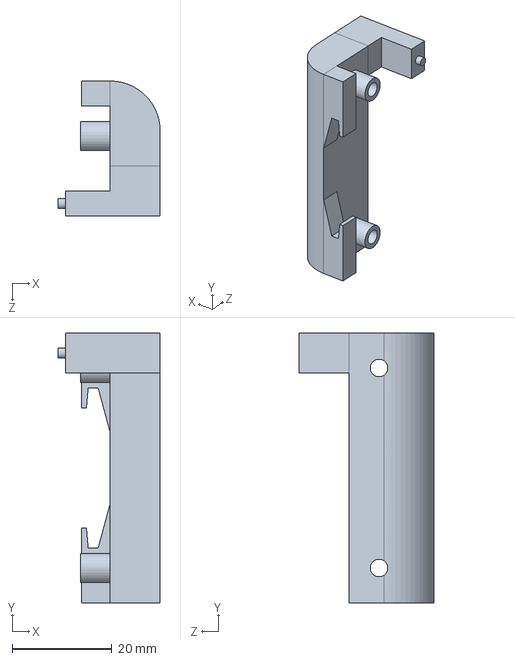
[picture p103: CAD file, 2023-01-28]
Scara_3D_design/Rack and Pinion Gear/Penyanga Rack.SLDPRT
20.5 x 54.0 x 27.0 mm
