lpnam1411/Scara_Robot/Scara_3D_design/Trục/GT2 Pulley - 8 - 30 teeth.SLDPRT

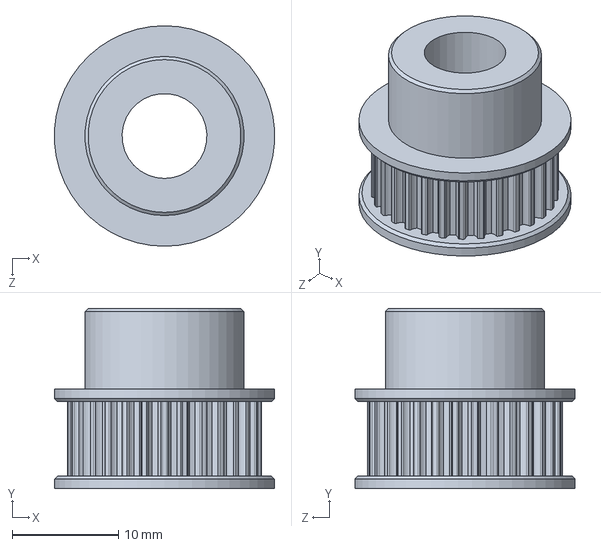
[picture p104: CAD file, 2023-01-28]
Scara_3D_design/Trục/GT2 Pulley - 8 - 30 teeth.SLDPRT
20.7 x 17.0 x 20.8 mm
