lpnam1411/Scara_Robot/Scara_3D_design/Base_hop.SLDPRT

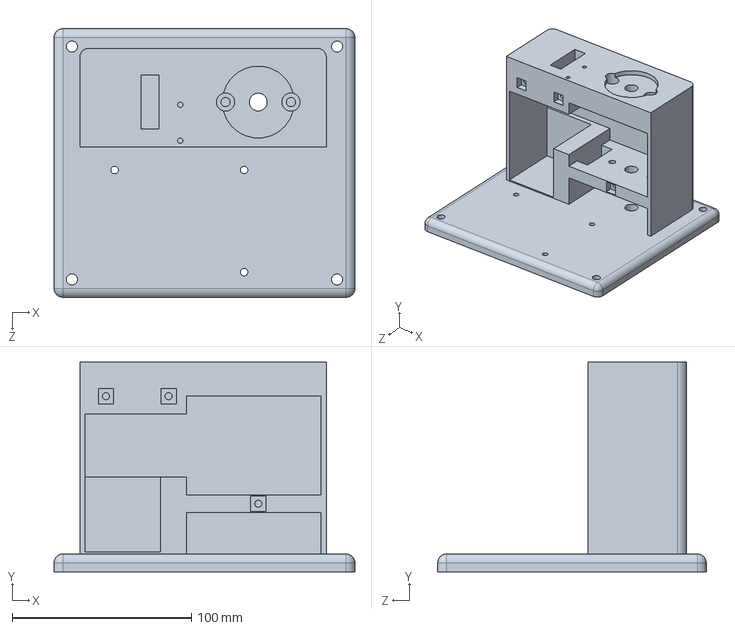
[picture p105: CAD file, 2023-01-28]
Scara_3D_design/Base_hop.SLDPRT
168.0 x 117.0 x 150.0 mm
