lpnam1411/Scara_Robot/Scara_3D_design/Linh kiện/Arduino Nano/atmega328.SLDPRT

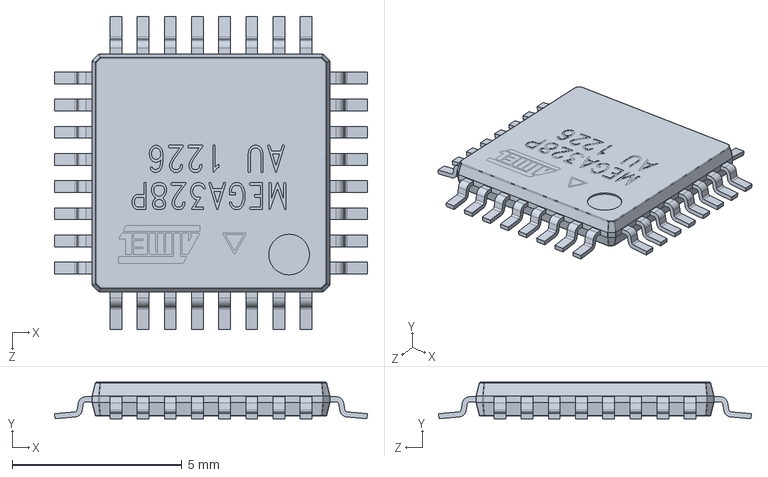
[picture p106: CAD file, 2023-01-28]
Scara_3D_design/Linh kiện/Arduino Nano/atmega328.SLDPRT
9.21 x 1.07 x 9.21 mm
