lpnam1411/Scara_Robot/Scara_3D_design/Linh kiện/Lerdge microswitch.SLDPRT

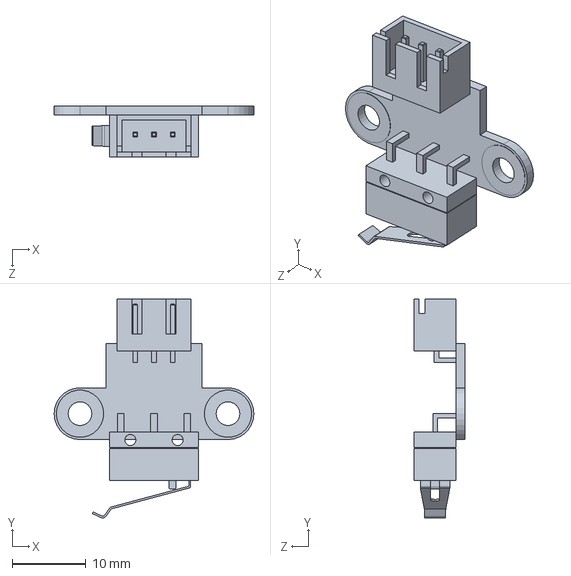
[picture p107: CAD file, 2023-01-28]
Scara_3D_design/Linh kiện/Lerdge microswitch.SLDPRT
27.0 x 29.6 x 6.90 mm
