lpnam1411/Scara_Robot/Scara_3D_design/Rack and Pinion Gear/straight bevel pinion_ai2.STEP

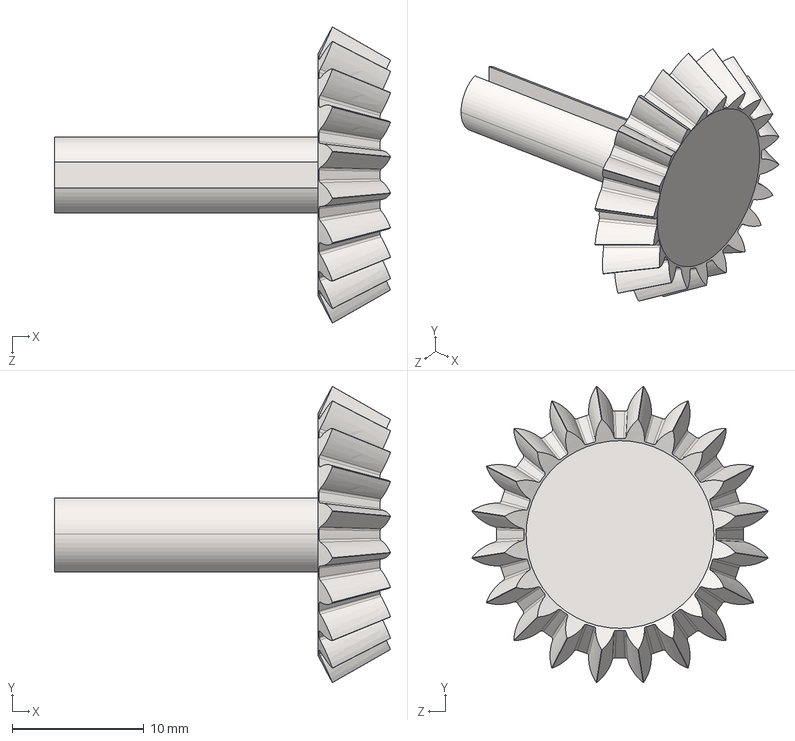
[picture p108: CAD file, 2023-01-28]
Scara_3D_design/Rack and Pinion Gear/straight bevel pinion_ai2.STEP
25.5 x 22.5 x 22.5 mm
