lpnam1411/Scara_Robot/Scara_3D_design/arduino_nap.SLDPRT

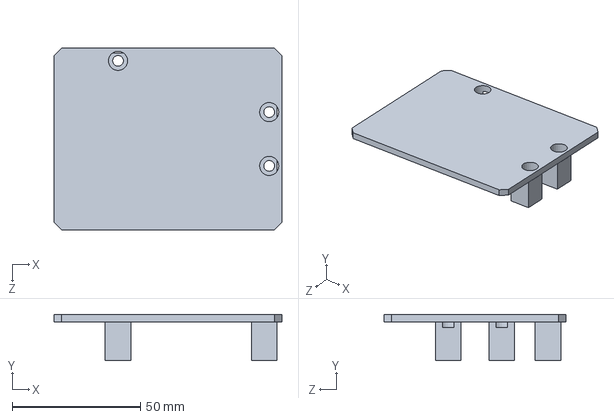
[picture p109: CAD file, 2023-01-28]
Scara_3D_design/arduino_nap.SLDPRT
89.0 x 18.0 x 71.0 mm
