lpnam1411/Scara_Robot/Scara_3D_design/Linh kiện/Arduino Nano/SMD Crystal 16MHz.SLDPRT

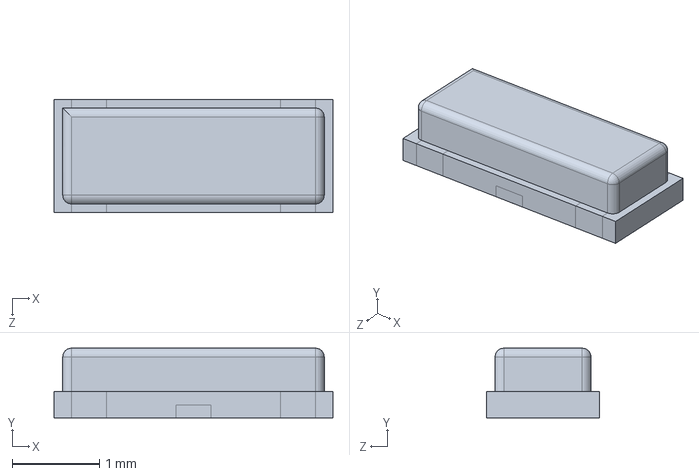
[picture p110: CAD file, 2023-01-28]
Scara_3D_design/Linh kiện/Arduino Nano/SMD Crystal 16MHz.SLDPRT
3.20 x 0.8 x 1.30 mm
