lpnam1411/Scara_Robot/Scara_3D_design/Rack and Pinion Gear/Part1pinion125_pulley.SLDPRT

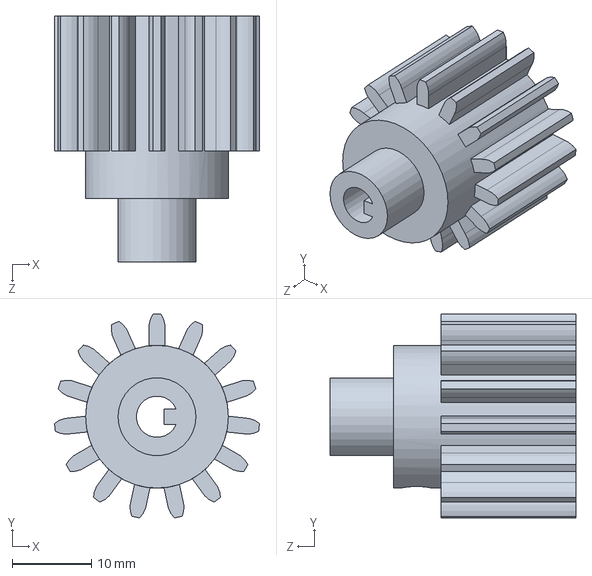
[picture p111: CAD file, 2023-01-28]
Scara_3D_design/Rack and Pinion Gear/Part1pinion125_pulley.SLDPRT
25.9 x 25.7 x 31.0 mm
