lpnam1411/Scara_Robot/Scara_3D_design/Trục/GT2 Belt Link 1.SLDPRT

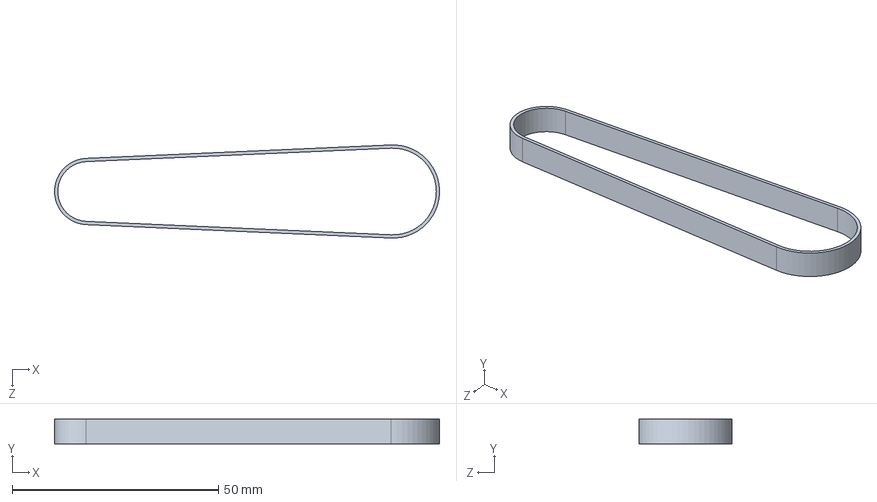
[picture p112: CAD file, 2023-01-28]
Scara_3D_design/Trục/GT2 Belt Link 1.SLDPRT
93.3 x 6.00 x 22.6 mm
