lpnam1411/Scara_Robot/Scara_3D_design/Base_nap.SLDPRT

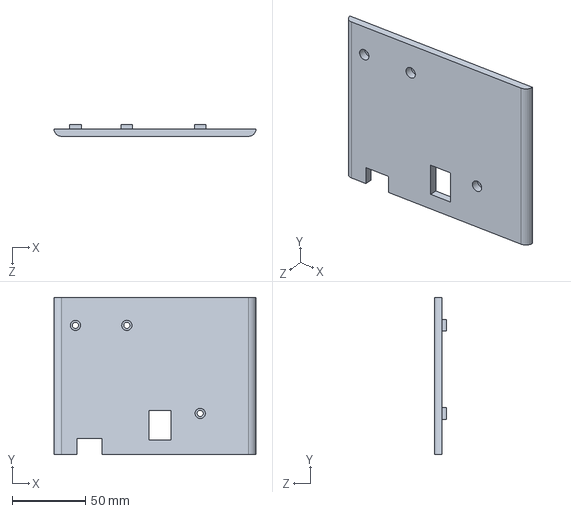
[picture p113: CAD file, 2023-01-28]
Scara_3D_design/Base_nap.SLDPRT
137.6 x 107.0 x 8.00 mm
