lpnam1411/Scara_Robot/Scara_3D_design/Linh kiện/Arduino Nano/0805 Chip SMD LED (2x1.2mm).step.SLDPRT

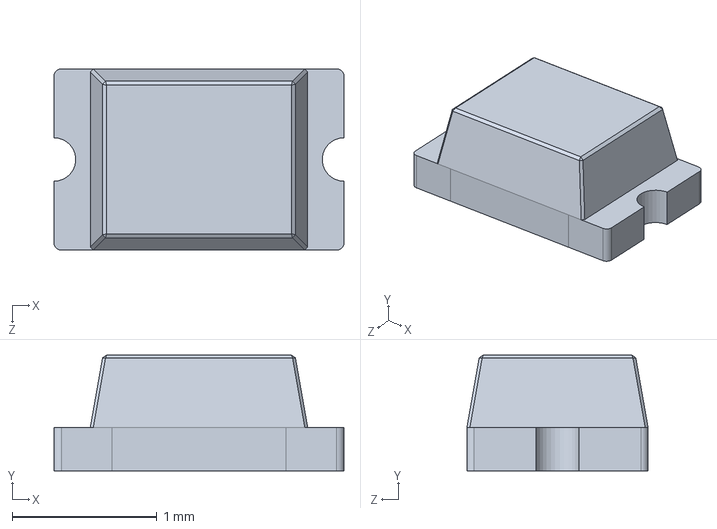
[picture p114: CAD file, 2023-01-28]
Scara_3D_design/Linh kiện/Arduino Nano/0805 Chip SMD LED (2x1.2mm).step.SLDPRT
2.00 x 0.8 x 1.25 mm
