lpnam1411/Scara_Robot/Scara_3D_design/Trục/GT2 Pulley - 23 - 80 teeth.SLDPRT

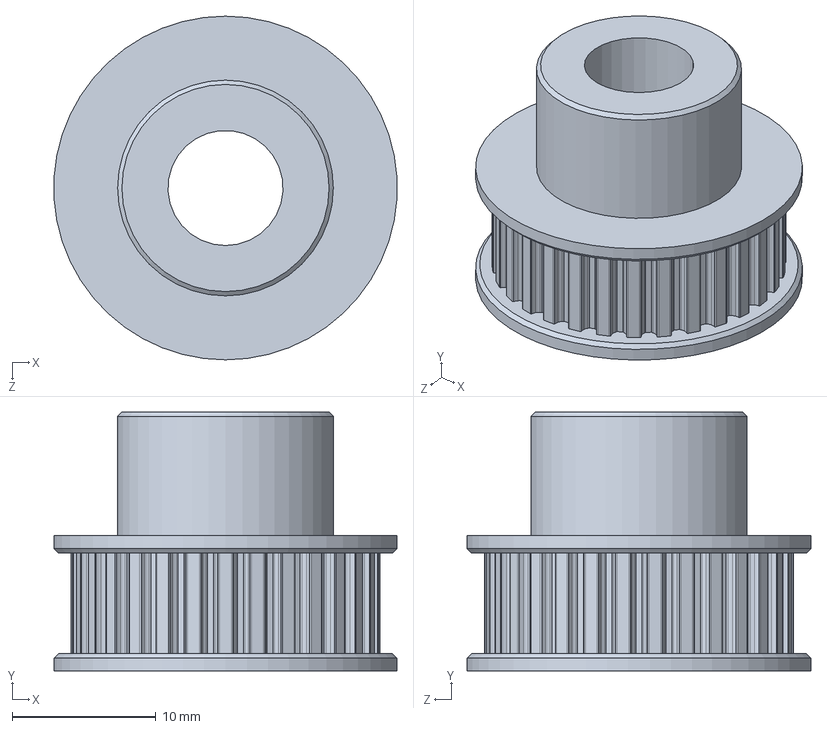
[picture p115: CAD file, 2023-01-28]
Scara_3D_design/Trục/GT2 Pulley - 23 - 80 teeth.SLDPRT
23.8 x 18.0 x 23.9 mm
