lpnam1411/Scara_Robot/Scara_3D_design/Linh kiện/Arduino Nano/Pushbutton3x4x2.SLDPRT

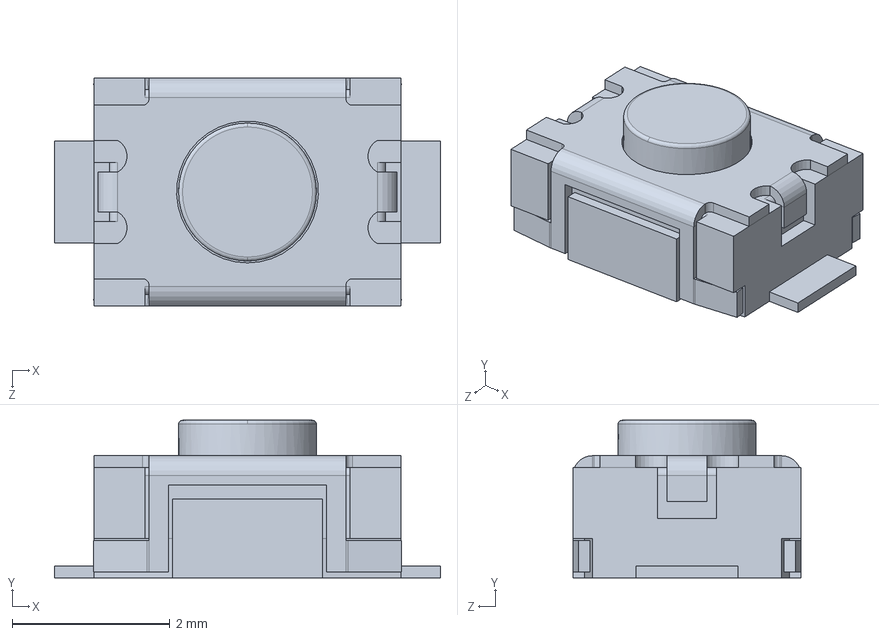
[picture p116: CAD file, 2023-01-28]
Scara_3D_design/Linh kiện/Arduino Nano/Pushbutton3x4x2.SLDPRT
4.90 x 2.00 x 2.90 mm
