lpnam1411/Scara_Robot/Scara_3D_design/Trục/Shaft Coupler 8-8mm.SLDPRT

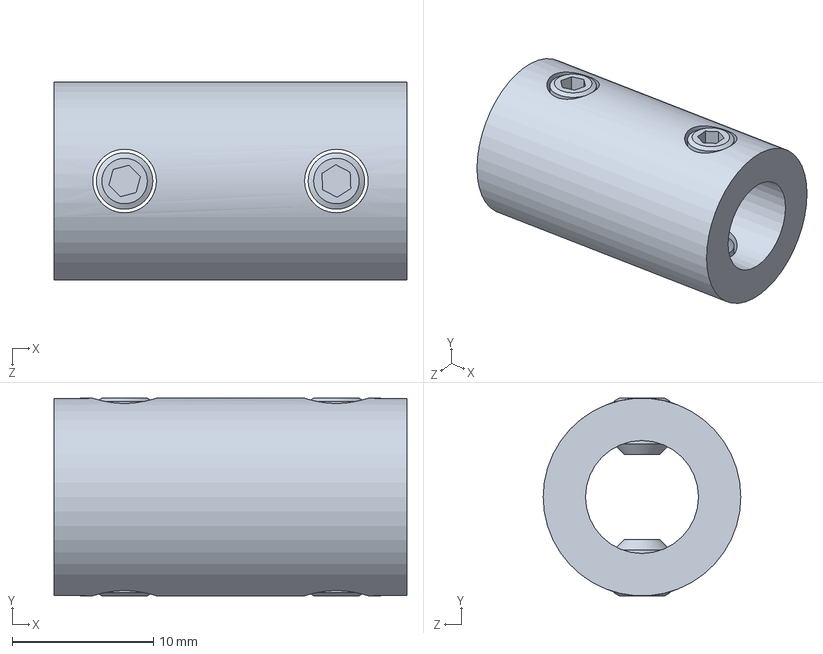
[picture p118: CAD file, 2023-01-28]
Scara_3D_design/Trục/Shaft Coupler 8-8mm.SLDPRT
25.0 x 14.0 x 14.0 mm
