lpnam1411/Scara_Robot/Scara_3D_design/Linh kiện/Arduino Nano/PLD-2.step.SLDPRT

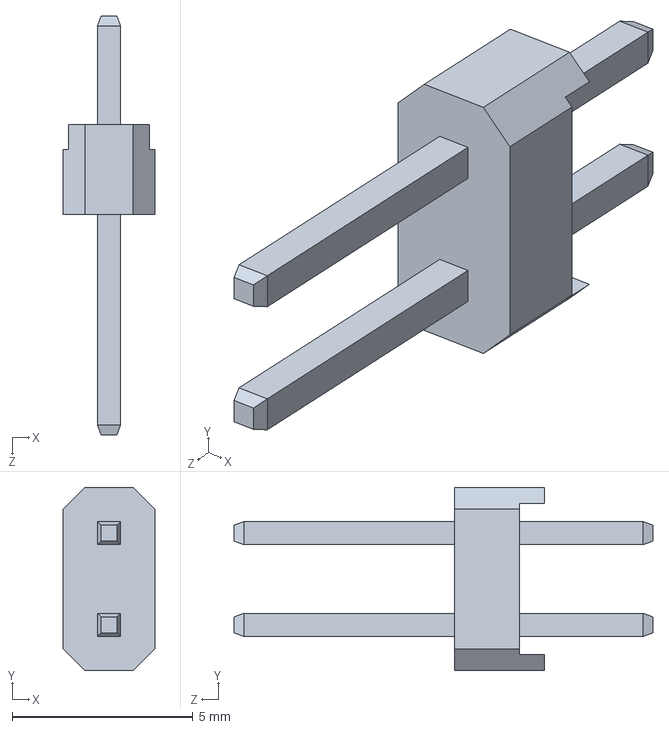
[picture p119: CAD file, 2023-01-28]
Scara_3D_design/Linh kiện/Arduino Nano/PLD-2.step.SLDPRT
2.54 x 5.08 x 11.6 mm
