lpnam1411/Scara_Robot/Scara_3D_design/Link2_Hop.SLDPRT

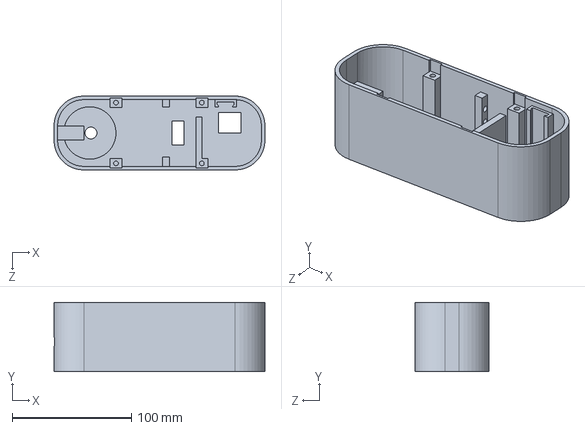
[picture p120: CAD file, 2023-01-28]
Scara_3D_design/Link2_Hop.SLDPRT
177.0 x 57.9 x 62.0 mm
