lpnam1411/Scara_Robot/Scara_3D_design/Rack and Pinion Gear/MR126-2RS Thrus Bearing- Thinhhouy.STEP

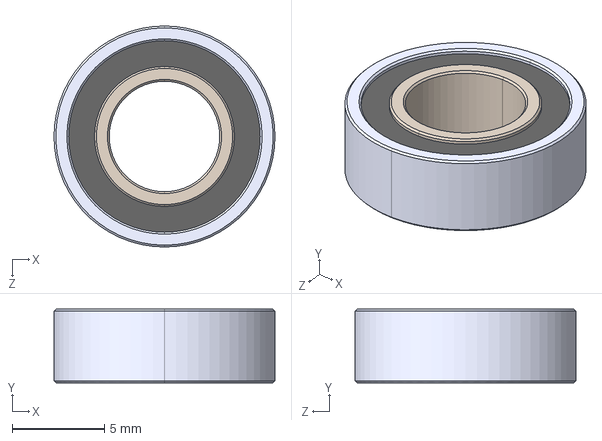
[picture p121: CAD file, 2023-01-28]
Scara_3D_design/Rack and Pinion Gear/MR126-2RS Thrus Bearing- Thinhhouy.STEP
12.0 x 4.00 x 12.0 mm
