lpnam1411/Scara_Robot/Scara_3D_design/Linh kiện/Arduino Nano/Diode MBR0520.SLDPRT

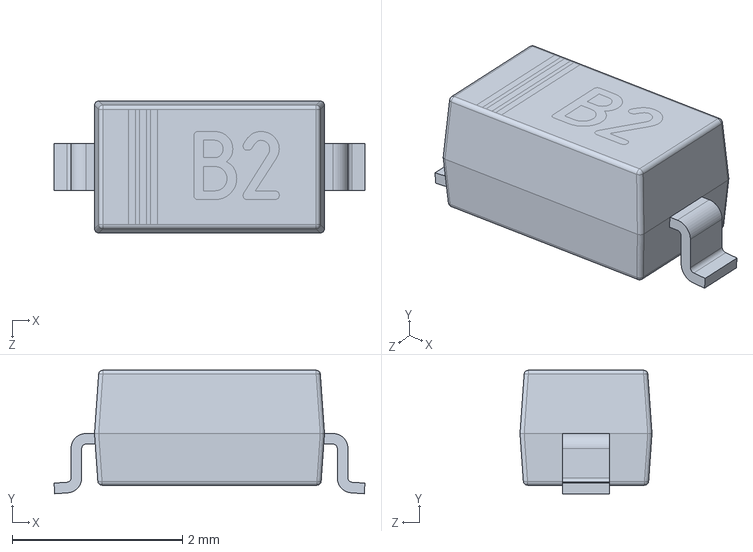
[picture p122: CAD file, 2023-01-28]
Scara_3D_design/Linh kiện/Arduino Nano/Diode MBR0520.SLDPRT
3.65 x 1.45 x 1.55 mm
