lpnam1411/Scara_Robot/Scara_3D_design/Link1_Nap.SLDPRT

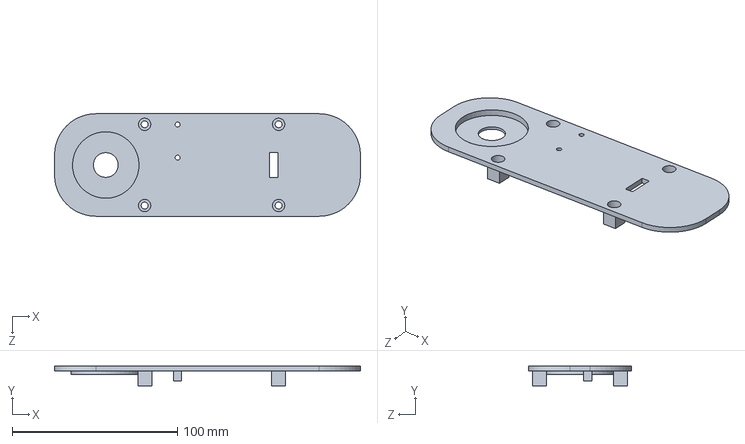
[picture p123: CAD file, 2023-01-28]
Scara_3D_design/Link1_Nap.SLDPRT
185.0 x 12.0 x 62.0 mm
