lpnam1411/Scara_Robot/Scara_3D_design/Trục/GT2 Pulley - Parametric.SLDPRT

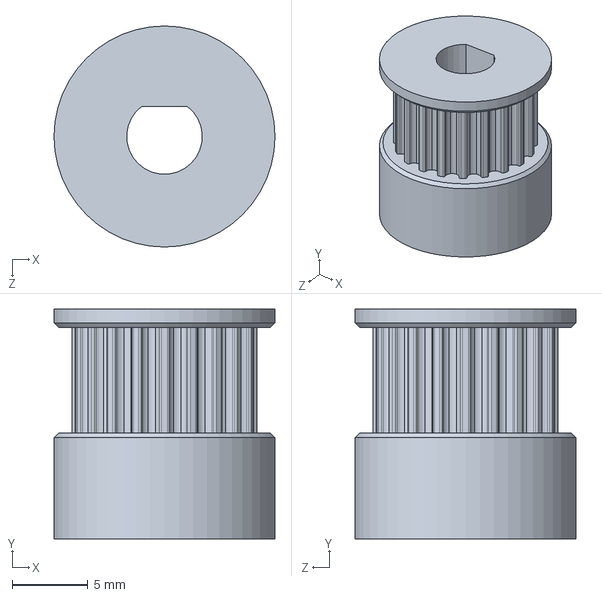
[picture p124: CAD file, 2023-01-28]
Scara_3D_design/Trục/GT2 Pulley - Parametric.SLDPRT
14.6 x 15.2 x 14.6 mm
