lpnam1411/Scara_Robot/Scara_3D_design/Linh kiện/Arduino Nano/102 RESISTOR PACK.SLDPRT

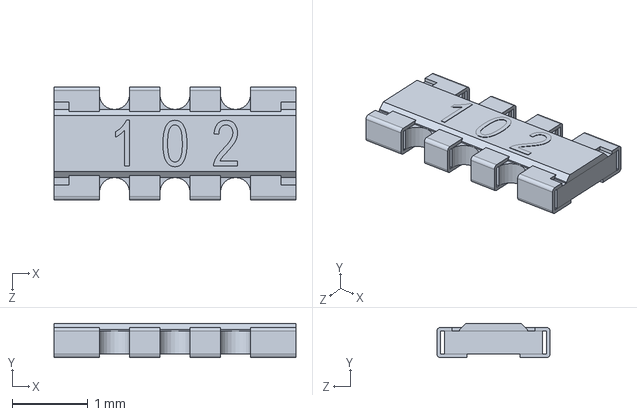
[picture p125: CAD file, 2023-01-28]
Scara_3D_design/Linh kiện/Arduino Nano/102 RESISTOR PACK.SLDPRT
3.20 x 0.455 x 1.50 mm
