lpnam1411/Scara_Robot/Scara_3D_design/Trục/Steel shaft 8mm diameter 20mm.SLDPRT

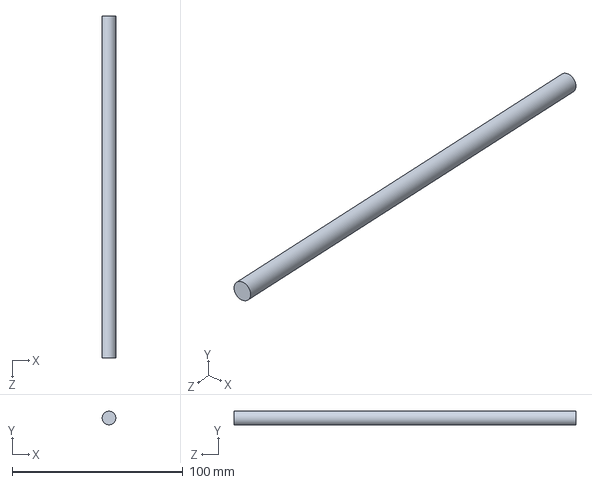
[picture p126: CAD file, 2023-01-28]
Scara_3D_design/Trục/Steel shaft 8mm diameter 20mm.SLDPRT
8.00 x 8.00 x 200.0 mm
