lpnam1411/Scara_Robot/Scara_3D_design/Linh kiện/Arduino Nano/C5 FD10 Reg.SLDPRT

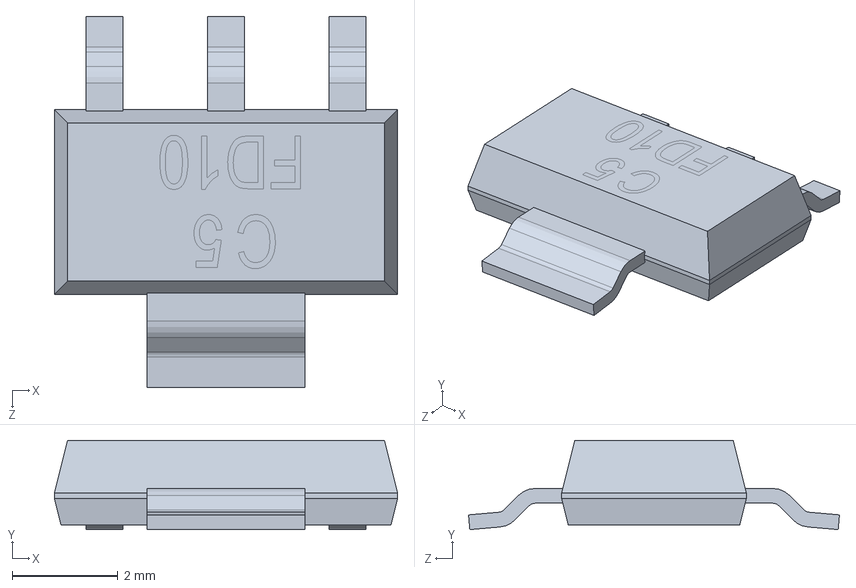
[picture p127: CAD file, 2023-01-28]
Scara_3D_design/Linh kiện/Arduino Nano/C5 FD10 Reg.SLDPRT
6.50 x 1.69 x 7.02 mm
