lpnam1411/Scara_Robot/Scara_3D_design/Rack and Pinion Gear/Part3rack.SLDPRT

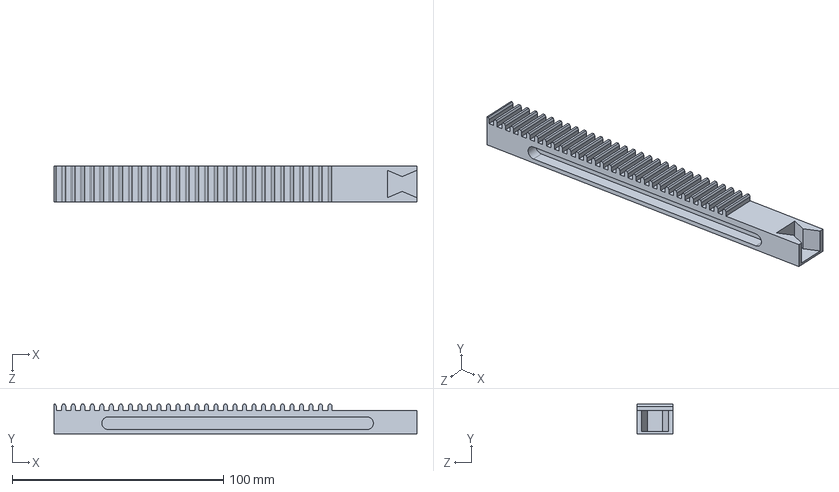
[picture p128: CAD file, 2023-01-28]
Scara_3D_design/Rack and Pinion Gear/Part3rack.SLDPRT
171.8 x 14.0 x 17.0 mm
