lpnam1411/Scara_Robot/Scara_3D_design/Linh kiện/Arduino Nano/FTDI FT232RL.SLDPRT

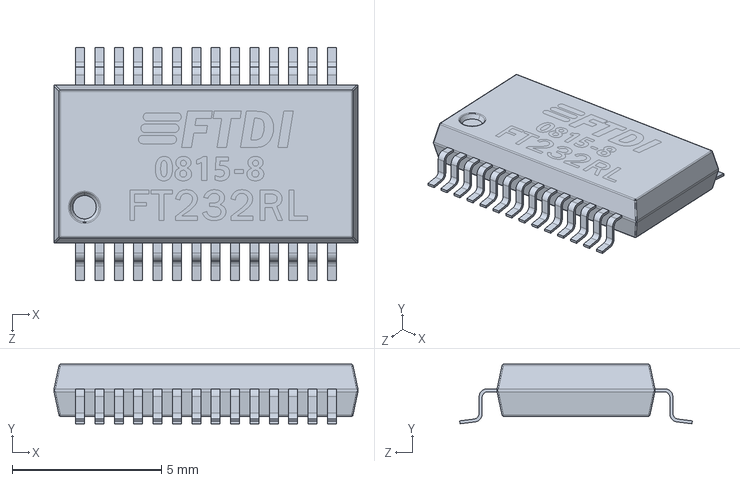
[picture p130: CAD file, 2023-01-28]
Scara_3D_design/Linh kiện/Arduino Nano/FTDI FT232RL.SLDPRT
10.2 x 2.00 x 7.81 mm
