lpnam1411/Scara_Robot/Scara_3D_design/Rack and Pinion Gear/Part12.SLDPRT

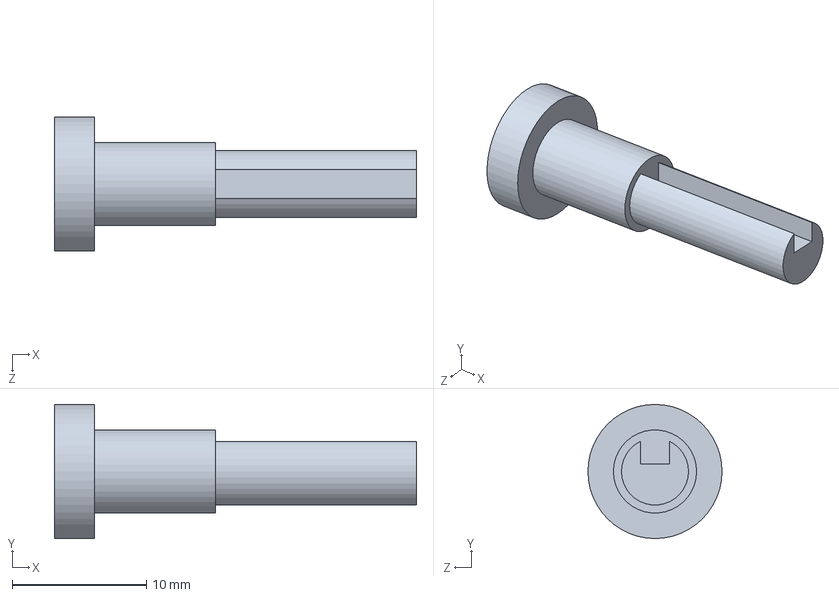
[picture p131: CAD file, 2023-01-28]
Scara_3D_design/Rack and Pinion Gear/Part12.SLDPRT
27.0 x 10.0 x 10.0 mm
