lpnam1411/Scara_Robot/Scara_3D_design/Trục/copper_shaft_m5_9.SLDPRT

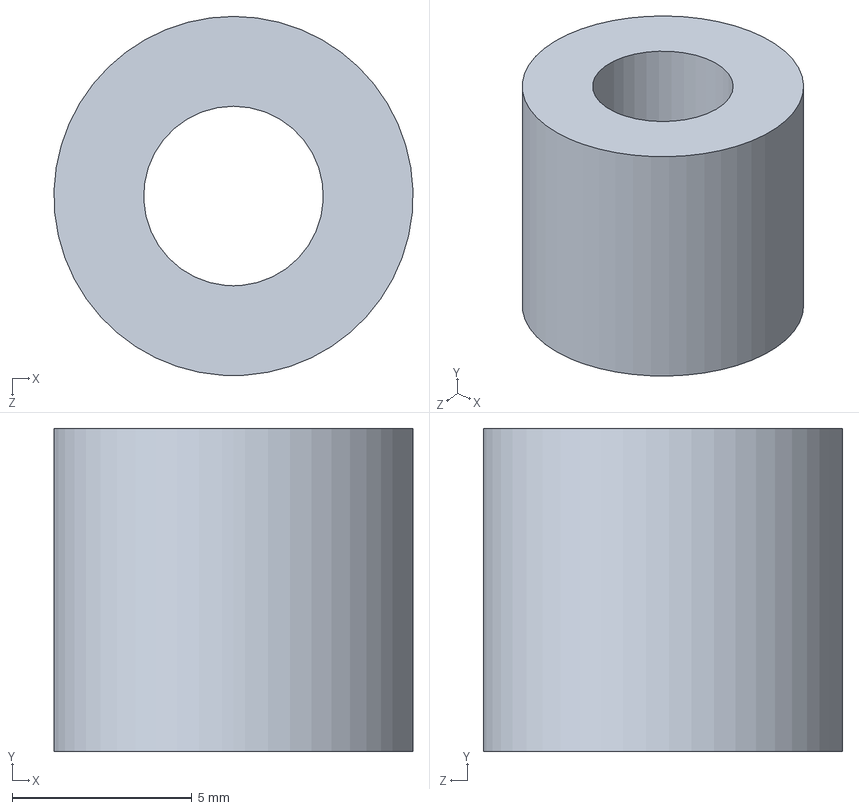
[picture p132: CAD file, 2023-01-28]
Scara_3D_design/Trục/copper_shaft_m5_9.SLDPRT
9.99 x 9.00 x 10.0 mm
