lpnam1411/Scara_Robot/Scara_3D_design/Linh kiện/Arduino Nano/1x15 Male Pin Header.SLDPRT

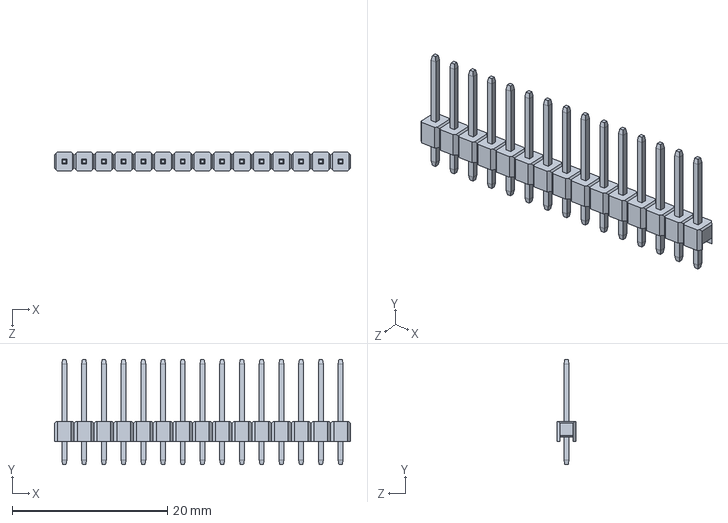
[picture p133: CAD file, 2023-01-28]
Scara_3D_design/Linh kiện/Arduino Nano/1x15 Male Pin Header.SLDPRT
38.1 x 13.5 x 2.50 mm
