lpnam1411/Scara_Robot/Scara_3D_design/Linh kiện/Arduino Nano/Tantalum Capacitor 475C A3216.SLDPRT

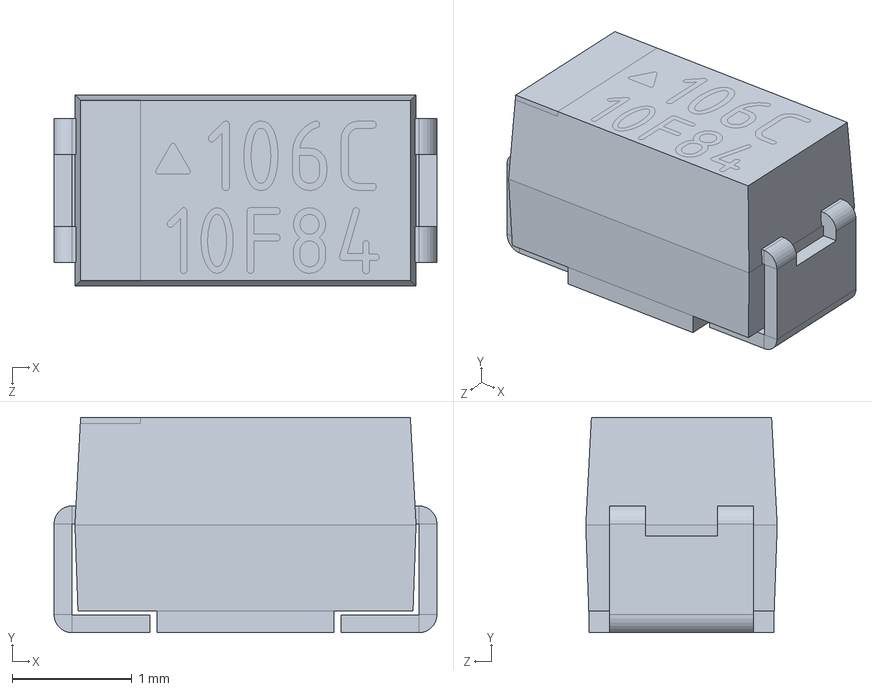
[picture p134: CAD file, 2023-01-28]
Scara_3D_design/Linh kiện/Arduino Nano/Tantalum Capacitor 475C A3216.SLDPRT
3.20 x 1.80 x 1.60 mm
