lpnam1411/Scara_Robot/Scara_3D_design/Linh kiện/Arduino Nano/User Library-C0805-2.step.SLDPRT

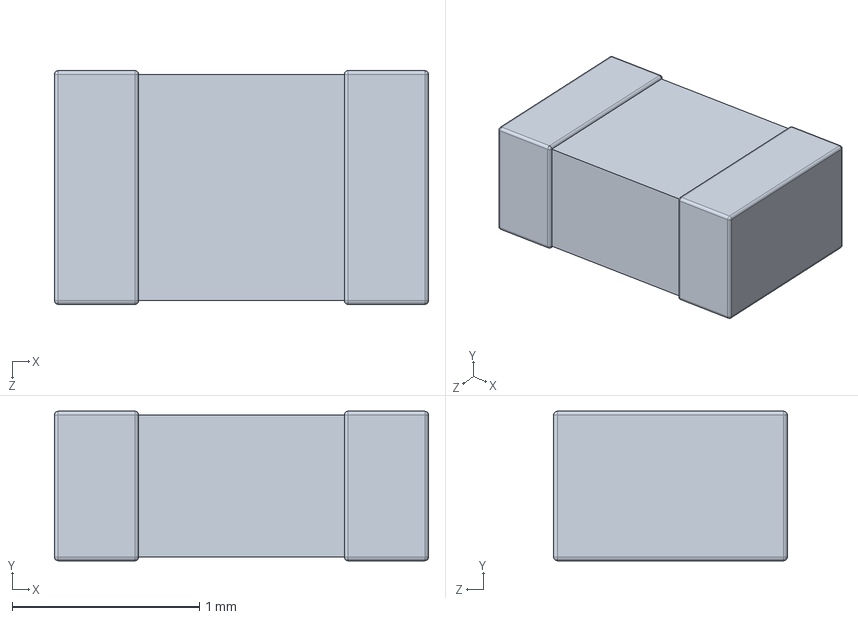
[picture p135: CAD file, 2023-01-28]
Scara_3D_design/Linh kiện/Arduino Nano/User Library-C0805-2.step.SLDPRT
2.00 x 0.8 x 1.25 mm
