lpnam1411/Scara_Robot/(list of files, cad)

Other CAD files:
Scara_3D_design/Rack and Pinion Gear/straight bevel pinion_aiii.STEP
Scara_3D_design/Trục/GT2 Pulley - 8 - 30 teethi.SLDPRT
Scara_3D_design/Linh kiện/Arduino Nano/189 RESISTOR PACK.SLDPRT
Scara_3D_design/Rack and Pinion Gear/Part1pinion125_pulley - Copy.SLDPRT
Scara_3D_design/Rack and Pinion Gear/Penyanga Rack - Copy.SLDPRT
Scara_3D_design/Rack and Pinion Gear/nut.SLDPRT
Scara_3D_design/Trục/51204.sldasm
Scara_3D_design/Trục/51204/51204.sldasm
Scara_3D_design/Trục/51204/51204_PART1.sldprt
Scara_3D_design/Trục/51204/51204_PART2.sldprt
Scara_3D_design/Trục/51204/51204_PART3.sldprt
Scara_3D_design/Trục/51204/51204_PART4.sldprt
